malakmarwan/Space-Garden/docs/Space Garden Poster.png

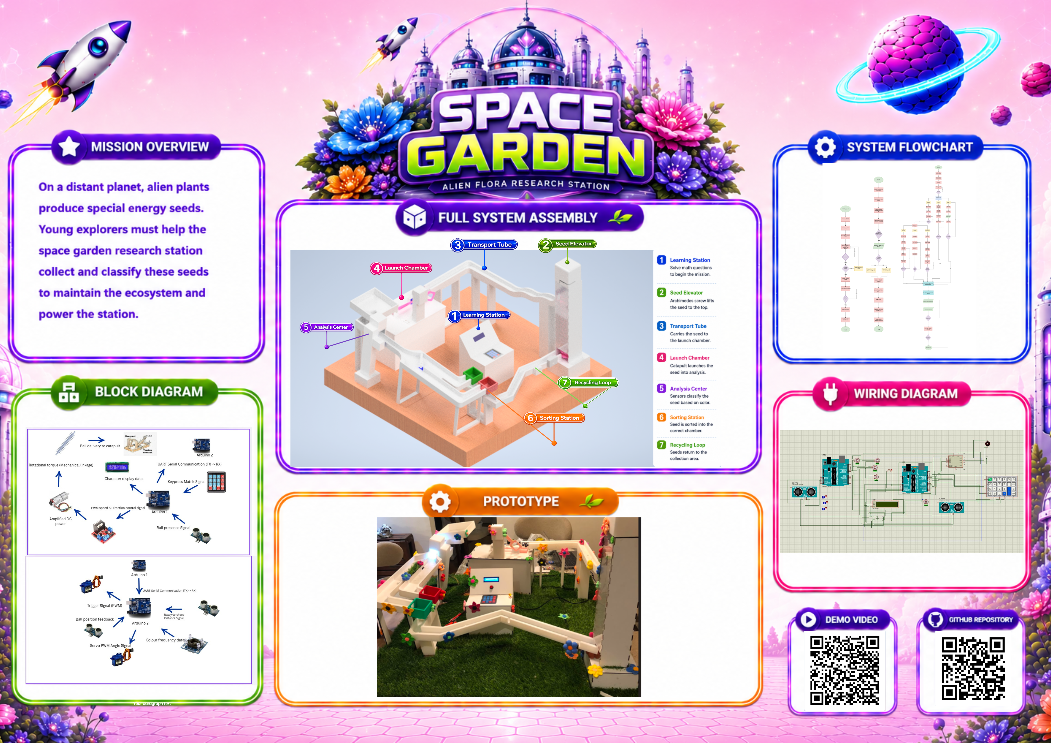
docs/Space Garden Poster.png
