malakmarwan/Space-Garden/Electrical/sorting mechanism wiring diagram.png

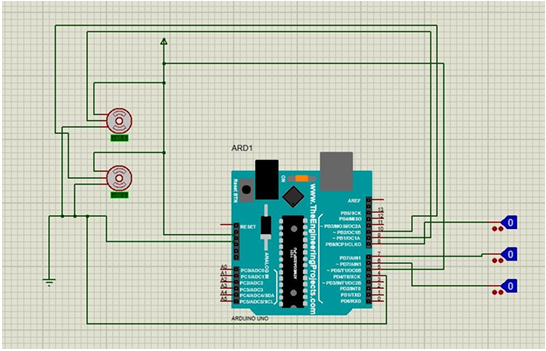
Electrical/sorting mechanism wiring diagram.png
