malakmarwan/Space-Garden/docs/Space Garden Report.pdf

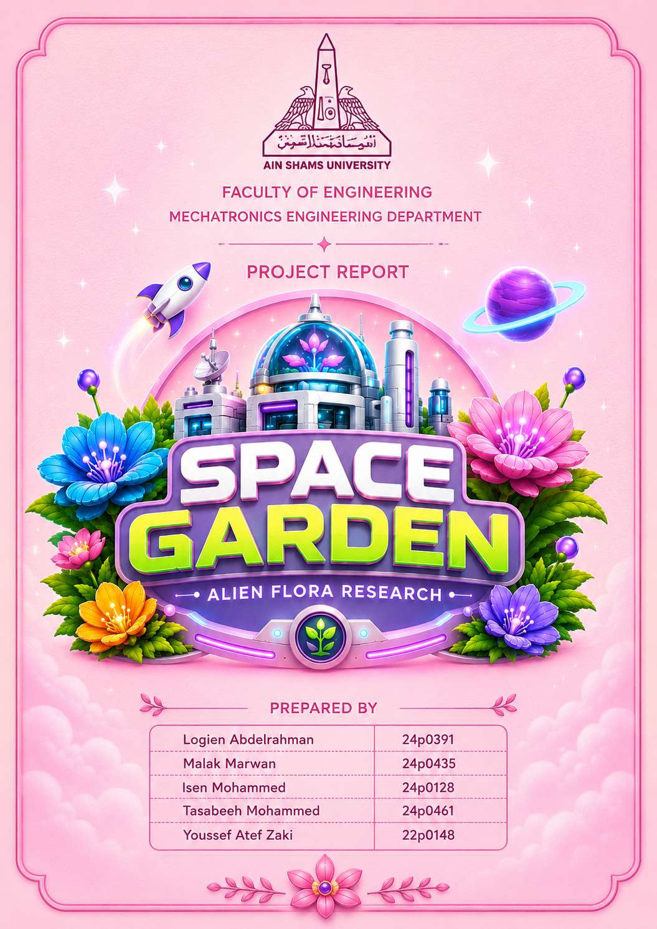
[picture p17: page 1]

This report details the design and implementation of an interactive educational mechatronics system developed. The project aims to bridge the gap between theoretical mathematical concepts and physical mechanical action through an automated sorting and delivery mechanism.

The core objective of this system is to create an engaging learning environment for children. The operational logic follows a feedback-controlled sequence:

1. User Interaction: A mathematical question is displayed on a digital interface.
2. Conditional Logic: If the child provides the correct answer, the system triggers the primary actuator to release a ball into the processing mechanisms.
- If the answer is incorrect, the system remains in a "hold" state, and the ball does not move, encouraging the user to try again.
3. Mechanical Execution: Once a correct answer is detected, the ball travels through a series of integrated subsystems, including vertical lifting, sorting mechanisms, and a final projectile shooting phase.

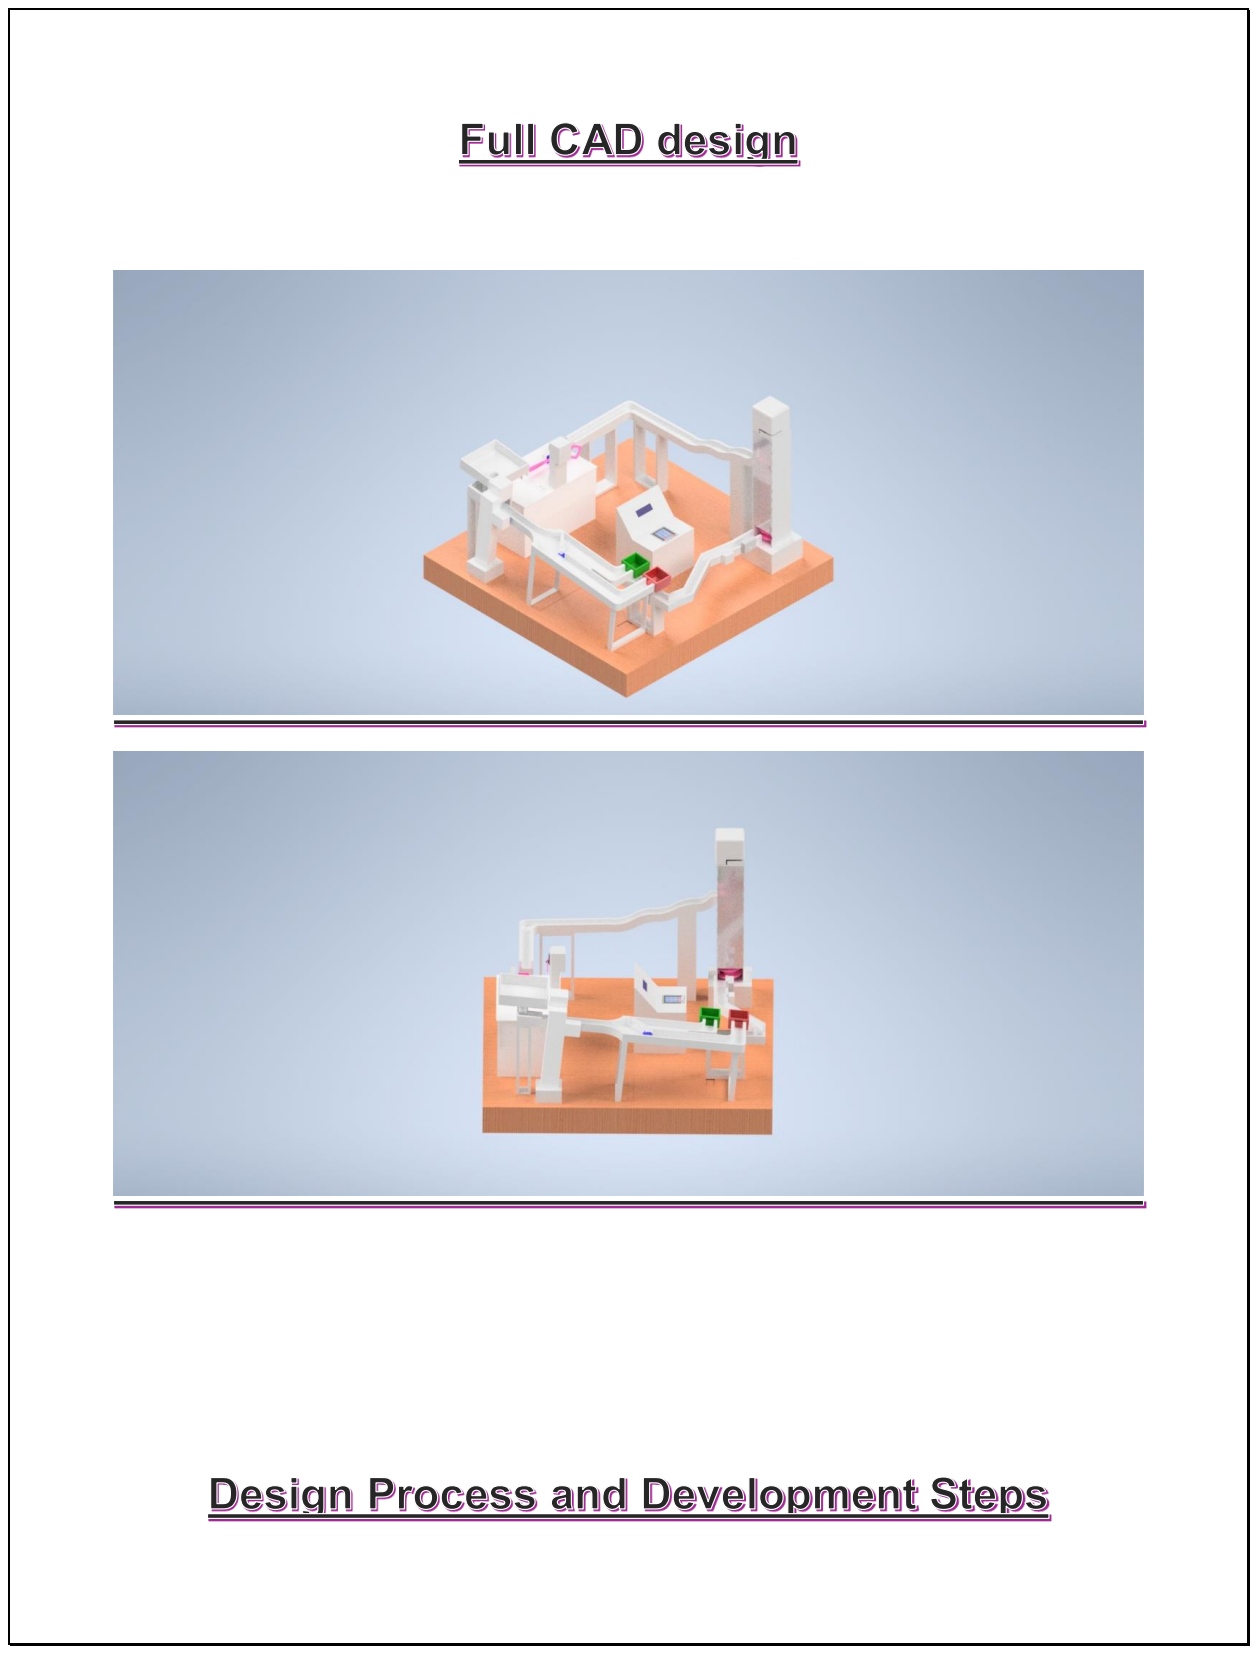
[picture p18: page 3]

### 1. Project Objective

The main objective of this project is to develop an automated ball sorting and handling system using Arduino-based control. The system combines color detection, object detection, user interaction, motor control, and servo mechanisms to create a complete automated process. The project was designed and simulated using Proteus before hardware implementation.

### 2. System Analysis

The required system functions were analyzed and divided into several stages:

1. User interaction and game control.
2. Ball detection.
3. Ball lifting mechanism.
4. Color recognition and sorting.
5. Ball shooting mechanism.
6. Communication between subsystems.

To simplify the design and reduce processing load, the system was divided into two Arduino controllers.

### 3. Hardware Selection

The following components were selected:

- Arduino Uno (2 units)
- LCD 16×2 I2C Display

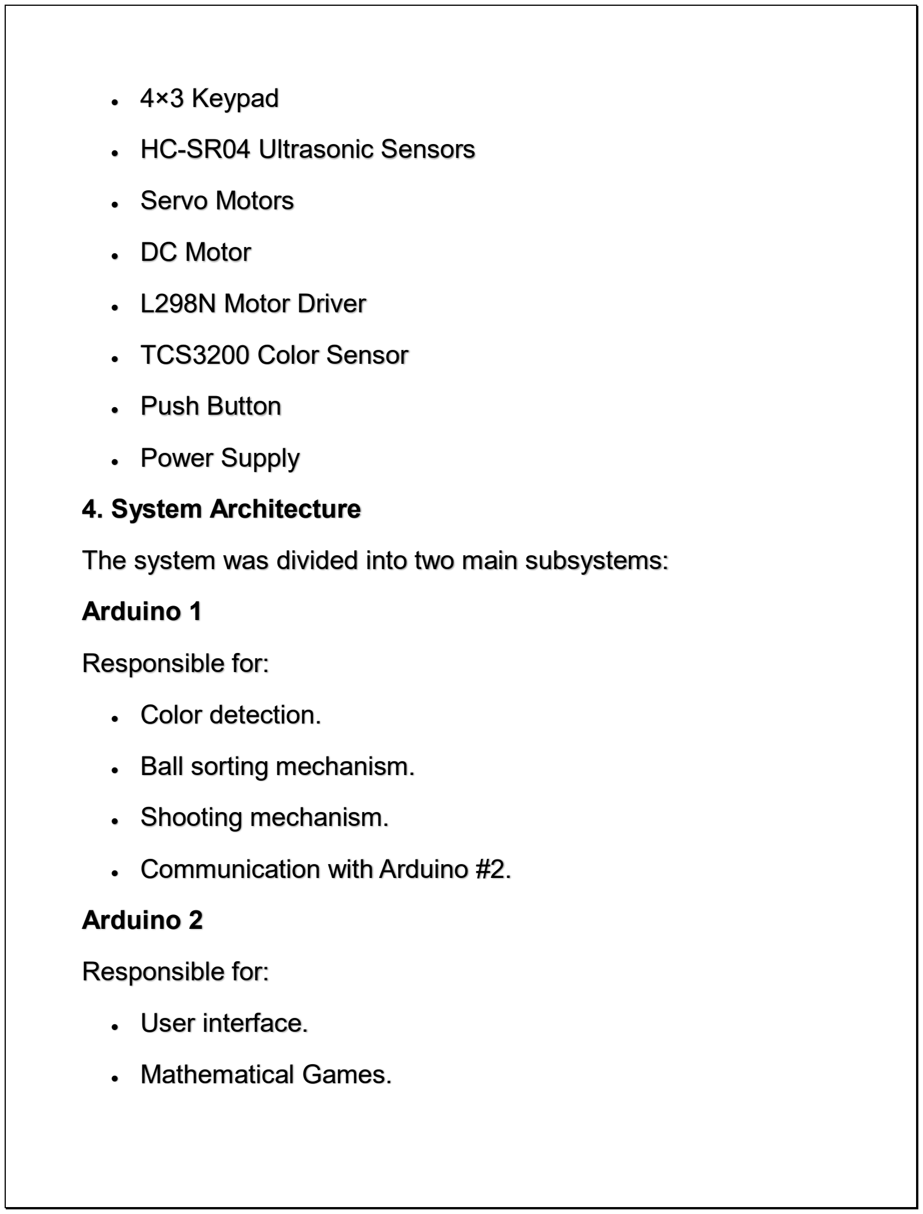
[picture p19: page 5]

- 4×3 Keypad
- HC-SR04 Ultrasonic Sensors
- Servo Motors
- DC Motor
- L298N Motor Driver
- TCS3200 Color Sensor
- Push Button
- Power Supply

### 4. System Architecture

The system was divided into two main subsystems:

Arduino 1

Responsible for:

- Color detection.
- Ball sorting mechanism.
- Shooting mechanism.
- Communication with Arduino #2.

Arduino 2

Responsible for:

- User interface.
- Mathematical Games.

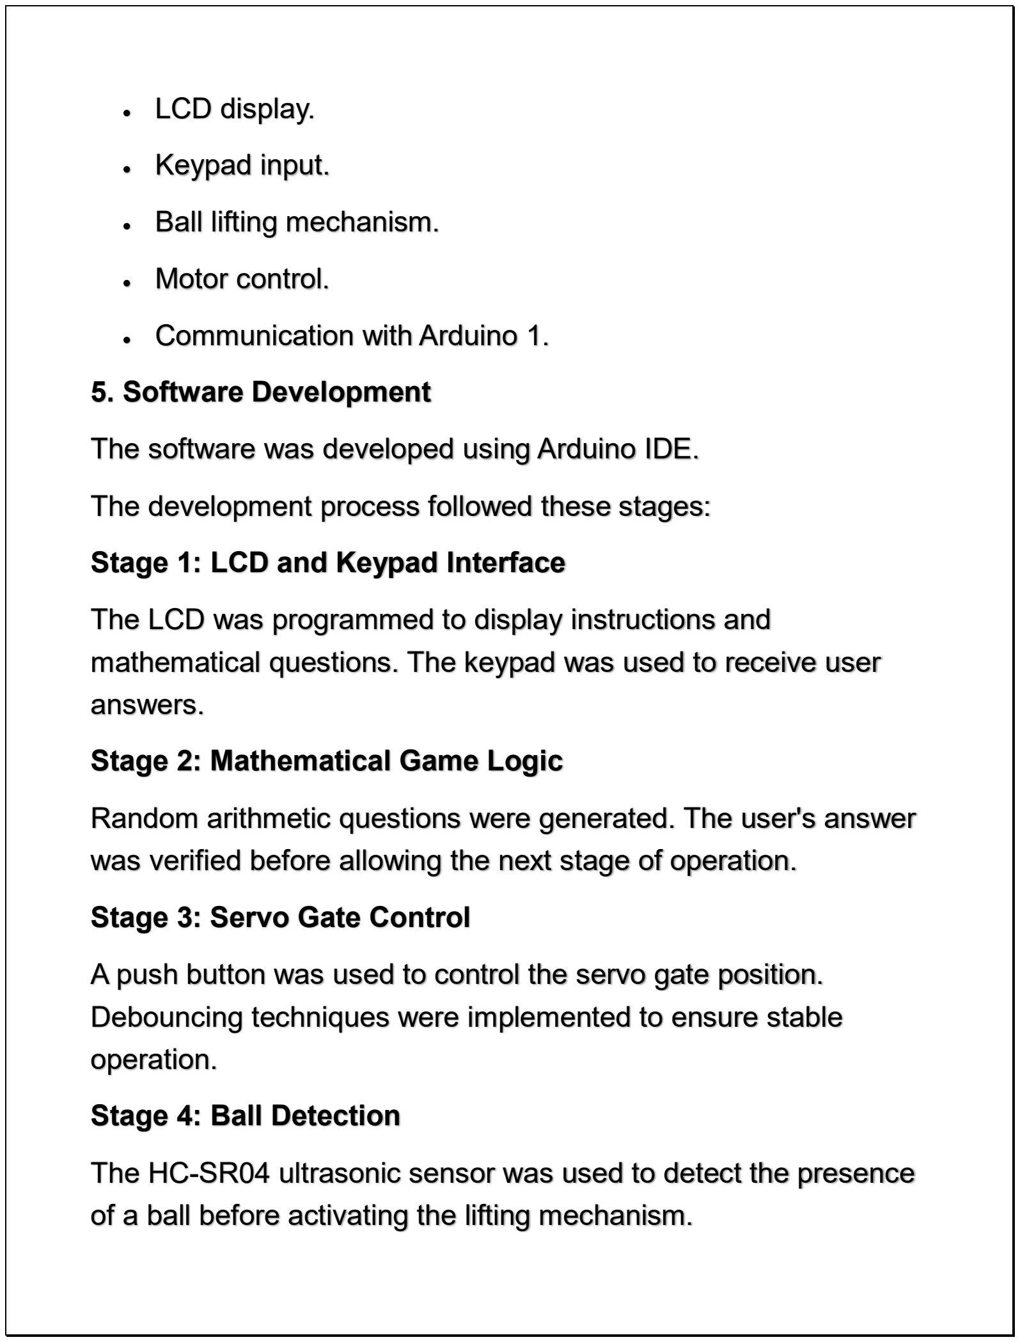
[picture p20: page 6]

- LCD display.
- Keypad input.
- Ball lifting mechanism.
- Motor control.
- Communication with Arduino 1.

### 5. Software Development

The software was developed using Arduino IDE.

The development process followed these stages:

Stage 1: LCD and Keypad Interface

The LCD was programmed to display instructions and mathematical questions. The keypad was used to receive user answers.

Stage 2: Mathematical Game Logic

Random arithmetic questions were generated. The user's answer was verified before allowing the next stage of operation.

Stage 3: Servo Gate Control

A push button was used to control the servo gate position. Debouncing techniques were implemented to ensure stable operation.

Stage 4: Ball Detection

The HC-SR04 ultrasonic sensor was used to detect the presence of a ball before activating the lifting mechanism.

Stage 5: Motor Control

The DC motor was controlled through an L298N motor driver. The motor operates for a predefined period to move the ball through the system.

Stage 6: Color Detection

The TCS3200 color sensor measures RGB values and compares them with calibrated reference values to identify ball color.

Stage 7: Sorting Mechanism

According to the detected color, servo motors move the sorting gate to direct the ball toward the appropriate path.

Stage 8: Shooting Mechanism

Additional servo motors perform the shooting sequence after successful sorting.

Stage 9: Arduino-to-Arduino Communication

Software Serial communication was implemented between the two Arduino boards to exchange system status messages such as:

- SHOOTING
- SORTING
- LIFTING

These messages are displayed on the LCD to provide user feedback.

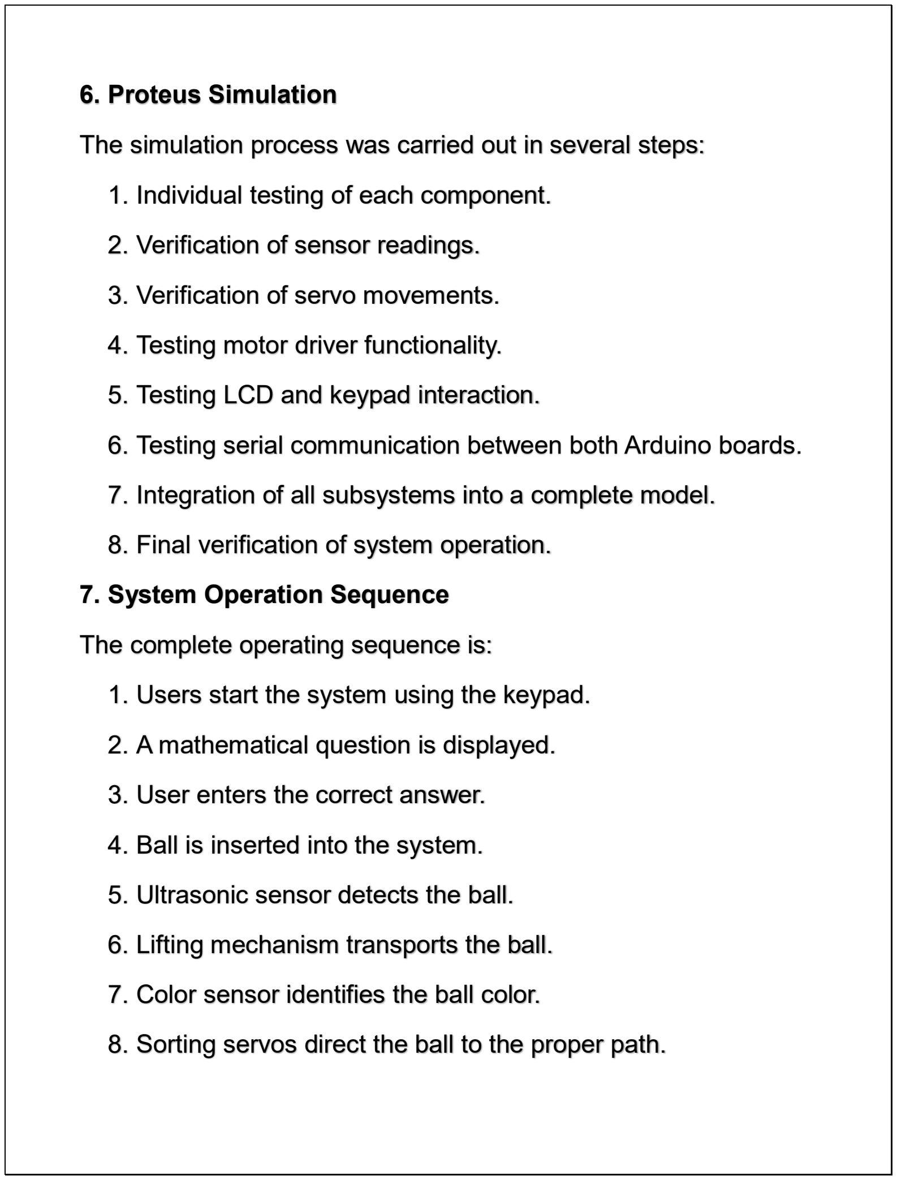
[picture p21: page 8]

### 6. Proteus Simulation

The simulation process was carried out in several steps:

1. Individual testing of each component.
2. Verification of sensor readings.
3. Verification of servo movements.
4. Testing motor driver functionality.
5. Testing LCD and keypad interaction.
6. Testing serial communication between both Arduino boards.
7. Integration of all subsystems into a complete model.
8. Final verification of system operation.

### 7. System Operation Sequence

The complete operating sequence is:

1. Users start the system using the keypad.
2. A mathematical question is displayed.
3. User enters the correct answer.
4. Ball is inserted into the system.
5. Ultrasonic sensor detects the ball.
6. Lifting mechanism transports the ball.
7. Color sensor identifies the ball color.
8. Sorting servos direct the ball to the proper path.

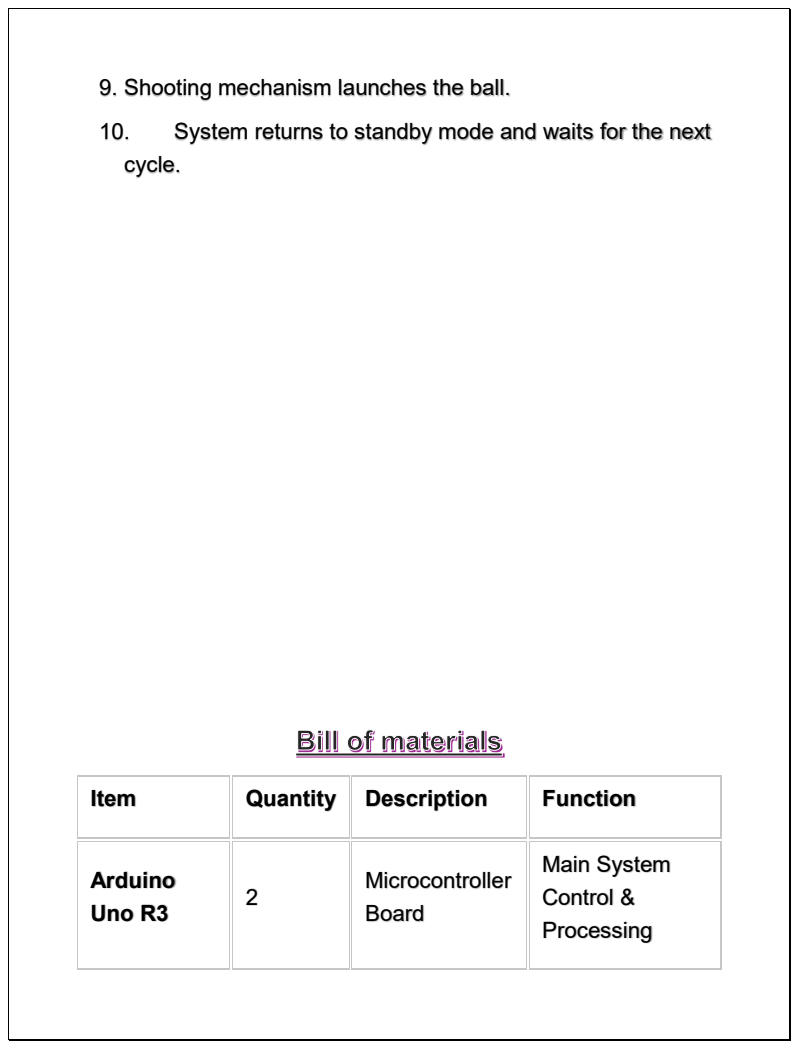
[picture p22: page 9]

9. Shooting mechanism launches the ball.

10. System returns to standby mode and waits for the next
cycle.

Item | Quantity | Description | Function

Arduino Uno R3 | 2 | Microcontroller Board | Main System Control & Processing

Item | Quantity | Description | Function

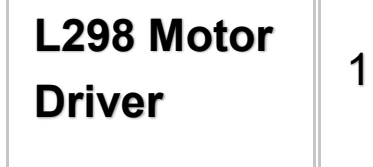
[picture p23: figure]

L298 Motor Driver | 1 | Dual H-Bridge Module | Motor Speed & Direction Control

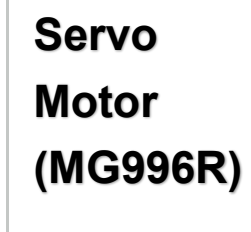
[picture p24: figure]
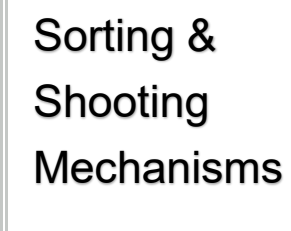
[picture p25: figure]

Servo Motor (MG996R) | 4 | High Torque Metal Gear | Sorting & Shooting Mechanisms

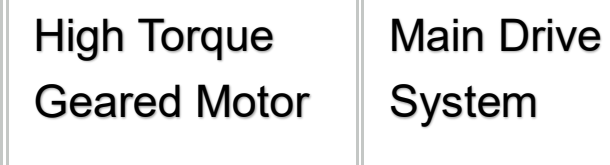
[picture p26: figure]

DC Motor (12V) | 1 | High Torque Geared Motor | Main Drive System

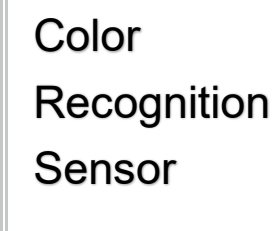
[picture p27: figure]

TCS3200 Sensor | 1 | Color Recognition Sensor | Ball Detection & Sorting

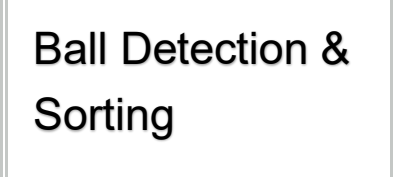
[picture p28: figure]
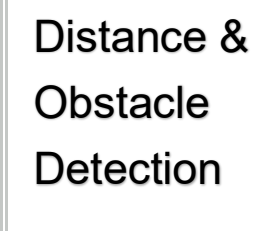
[picture p29: figure]

Ultrasonic Sensor | 2 | HC-SR04 | Distance & Obstacle Detection

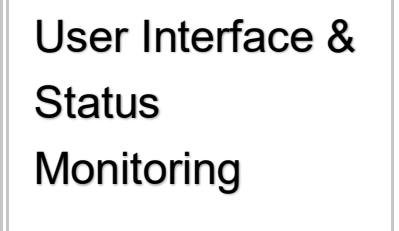
[picture p30: figure]

I2C LCD Display | 1 | 16x2 Character Display | User Interface & Status Monitoring
Keypad (4x4) | 1 | Membrane Keypad | User Input & Control

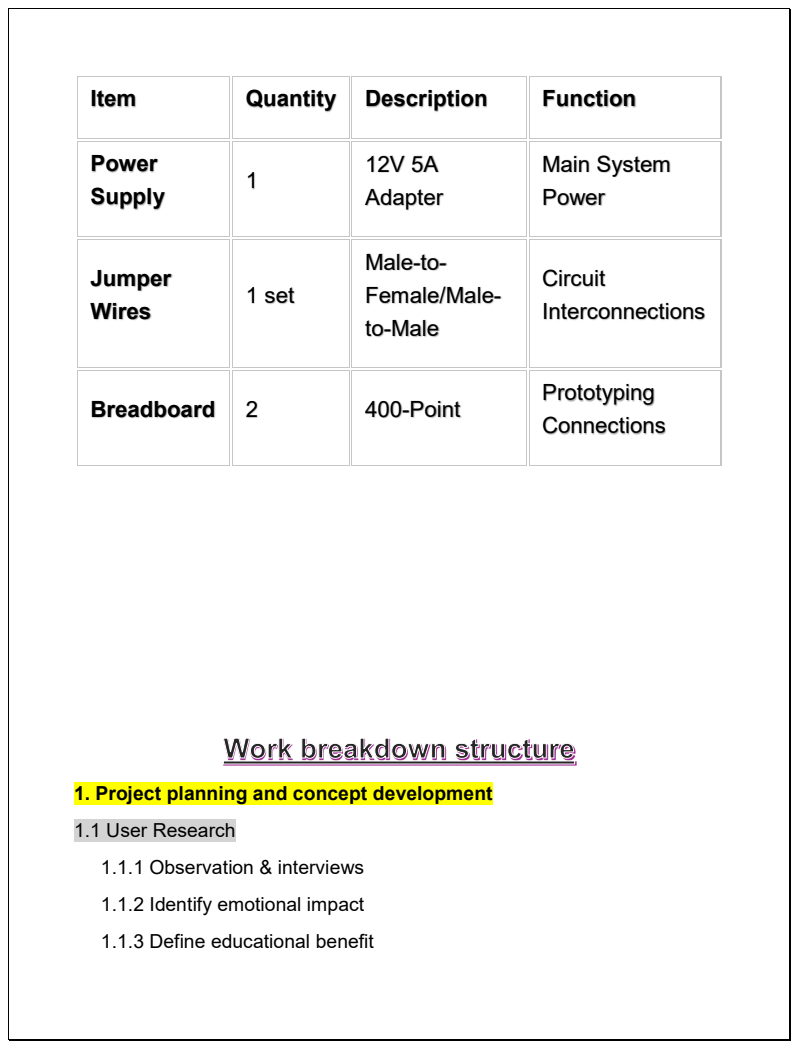
[picture p31: page 11]
1.1 User Research; 1.1.1 Observation & interviews

Item | Quantity | Description | Function

Power Supply | 1 | 12V 5A Adapter | Main System Power

Jumper Wires | 1 set | Male-to-Female/Male-to-Male | Circuit Interconnections

Breadboard | 2 | 400-Point | Prototyping Connections

1. Project planning and concept development

1.1.2 Identify emotional impact

1.1.3 Define educational benefit

1.2 Problem Definition

1.2.1 Requirement Analysis (sorting, shooting, lifting)

1.2.2 Define educational objectives

1.2.3 Define constraints (size, cost, safety)

1.3 Ideation

1.3.1Mind maps

1.3.2 Mood boards

1.3.3 Sketches

1.3.4 Concept selection

1.4 Product Design Specifications

### 2. Mechanical Subsystems

2.1 Vertical Lifting Mechanism

2.1.1 Mechanism selection

2.1.2 Torque calculation

2.1.3 Motor sizing

2.1.4 CAD modeling

2.1.5 Mechanical testing

2.2 Sorting Mechanism

2.2.1 Sorting principle (Color)

2.2.2 Sensor selection

2.2.3 Mechanical gate design (inventor)

2.2.4 Sorting validation testing

2.3 Projectile Shooting Mechanism

2.3.1 Concept selection (catapult)

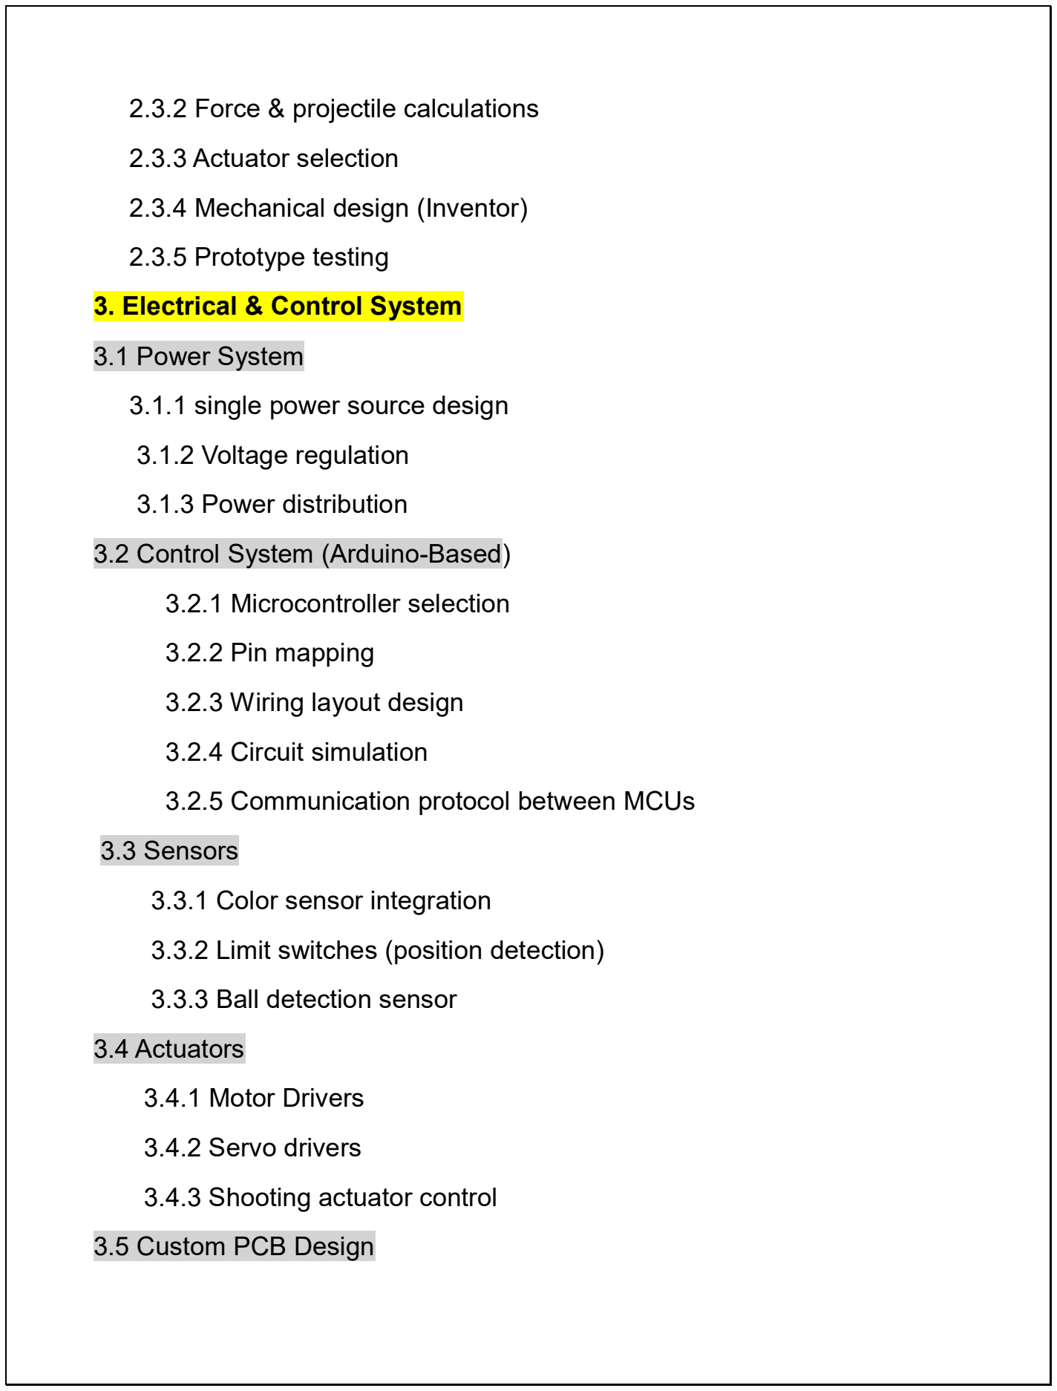
[picture p32: figure]
2.3.2 Force & projectile calculations; 2.3.3 Actuator selection; 2.3.4 Mechanical design (Inventor); 2.3.5 Prototype testing; 3. Electrical & Control System; 3.1 Power System; 3.1.1 single power source design; 3.1.2 Voltage regulation; 3.1.3 Power distribution; 3.2 Control System (Arduino-Based); 3.2.1 Microcontroller selection; 3.2.2 Pin mapping; 3.2.3 Wiring layout design; 3.2.4 Circuit simulation; 3.3 Sensors; 3.3.1 Color sensor integration; 3.3.3 Ball detection sensor; 3.4 Actuators; 3.4.1 Motor Drivers; 3.4.2 Servo drivers; 3.4.3 Shooting actuator control; 3.5 Custom PCB Design

3.2.5 Communication protocol between MCUs

3.3.2 Limit switches (position detection)

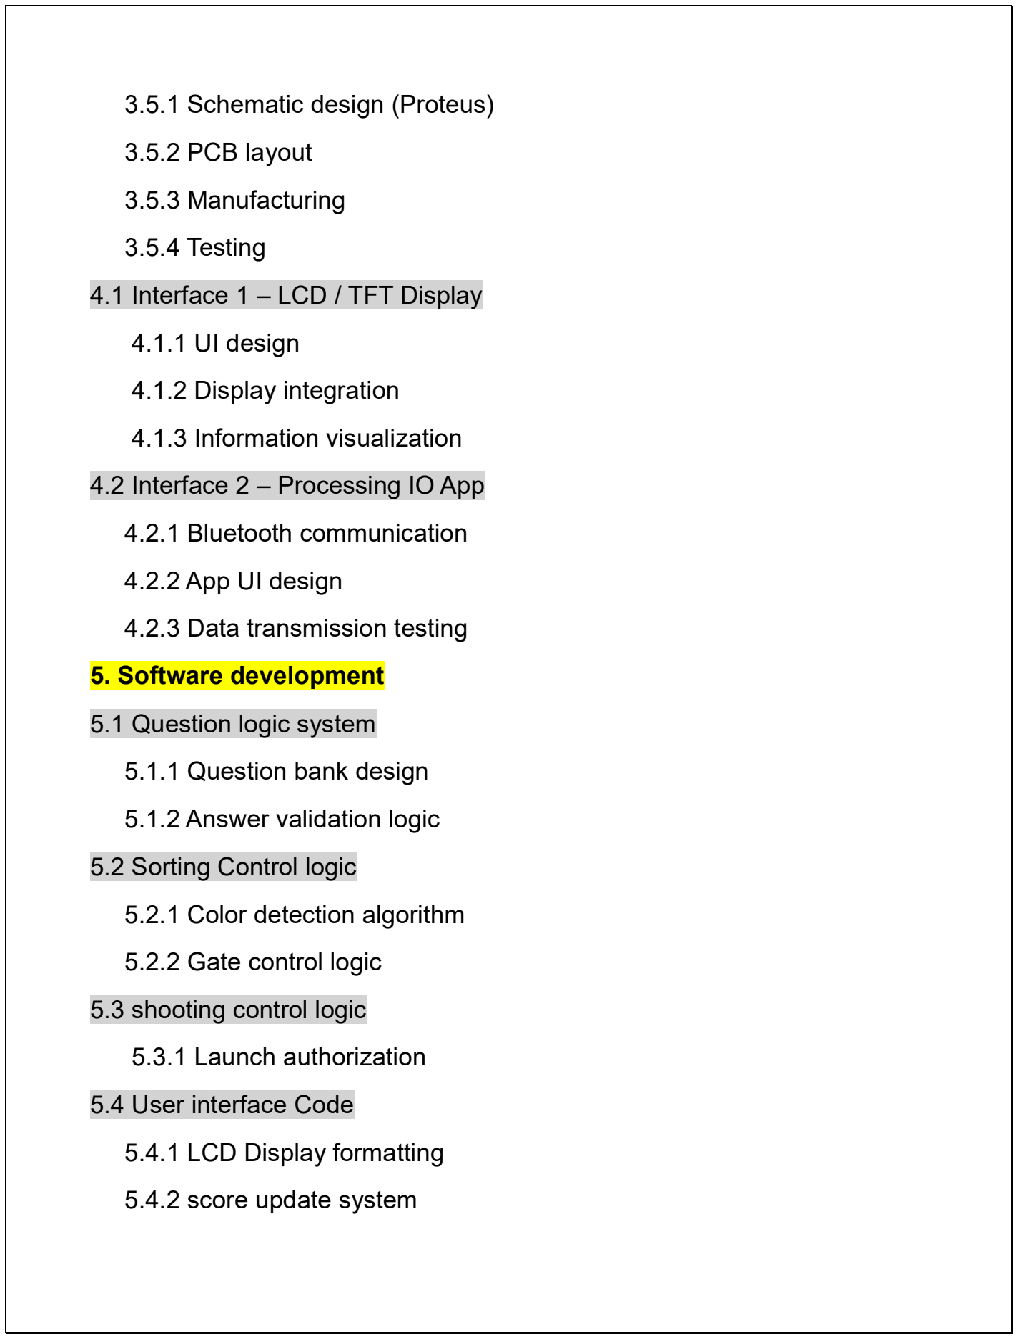
[picture p33: figure]
3.5.1 Schematic design (Proteus); 3.5.2 PCB layout; 3.5.3 Manufacturing; 3.5.4 Testing; 4.1 Interface 1 – LCD / TFT Display; 4.1.1 UI design; 4.1.2 Display integration; 4.1.3 Information visualization; 4.2 Interface 2 – Processing IO App; 4.2.1 Bluetooth communication; 4.2.2 App UI design; 4.2.3 Data transmission testing; 5. Software development; 5.1 Question logic system; 5.1.1 Question bank design; 5.1.2 Answer validation logic; 5.2 Sorting Control logic; 5.2.1 Color detection algorithm; 5.2.2 Gate control logic; 5.3 shooting control logic; 5.3.1 Launch authorization; 5.4 User interface Code; 5.4.1 LCD Display formatting; 5.4.2 score update system

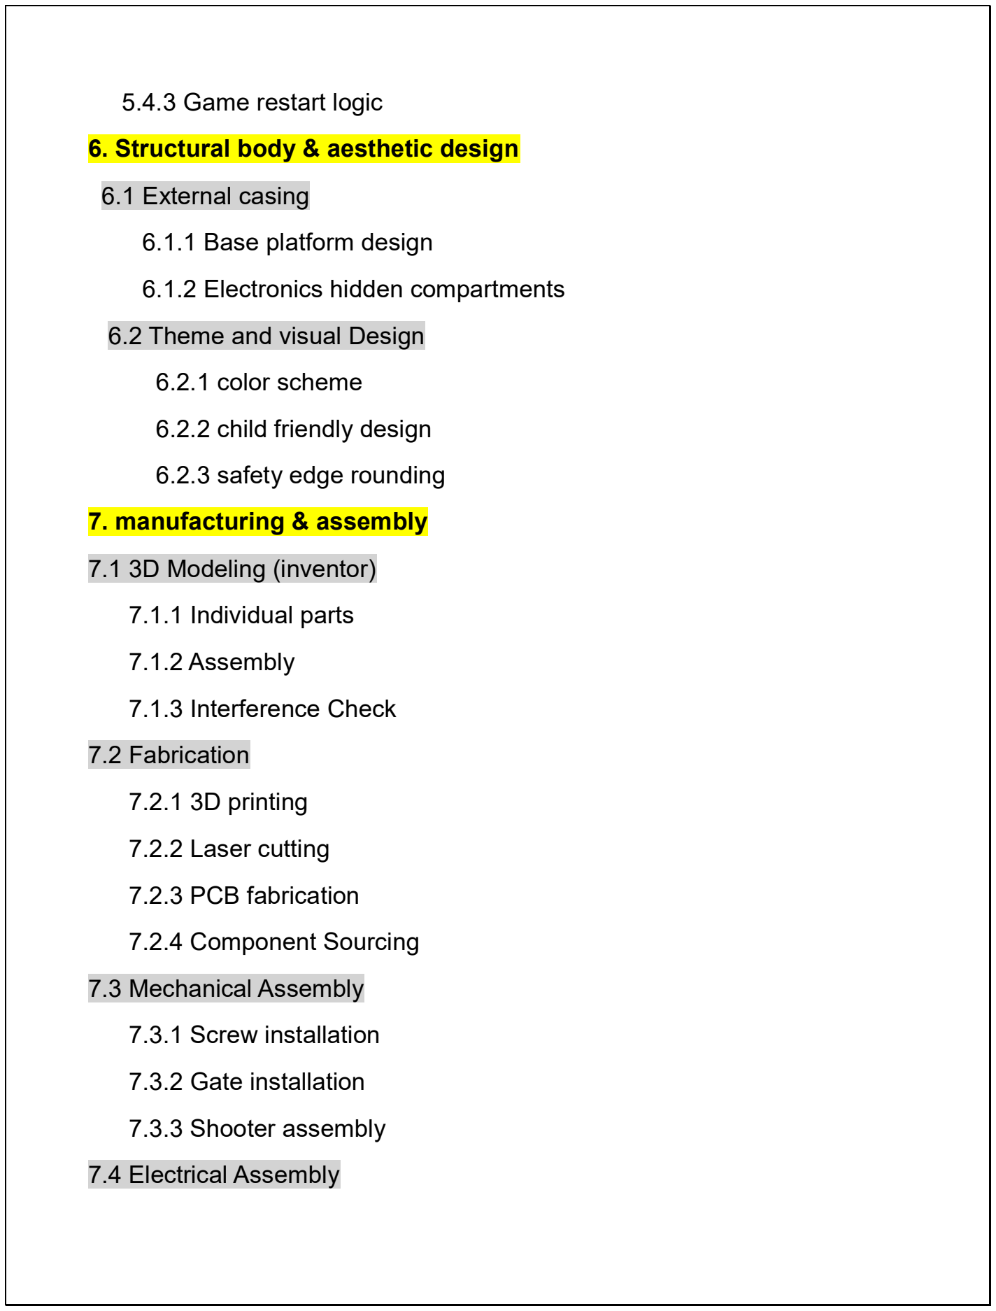
[picture p34: figure]
5.4.3 Game restart logic; 6. Structural body & aesthetic design; 6.1 External casing; 6.1.1 Base platform design; 6.1.2 Electronics hidden compartments; 6.2 Theme and visual Design; 6.2.1 color scheme; 6.2.2 child friendly design; 6.2.3 safety edge rounding; 7. manufacturing & assembly; 7.1 3D Modeling (inventor); 7.1.1 Individual parts; 7.1.2 Assembly; 7.1.3 Interference Check; 7.2 Fabrication; 7.2.1 3D printing; 7.2.2 Laser cutting; 7.2.3 PCB fabrication; 7.2.4 Component Sourcing; 7.3 Mechanical Assembly; 7.3.1 Screw installation; 7.3.2 Gate installation; 7.3.3 Shooter assembly; 7.4 Electrical Assembly

7.4.1 Wiring per Module

7.4.2 Cable management

7.5 System Integration

7.5.1 Mechanical–Electrical Integration

7.5.1.1 1Install motors into mechanical structure

7.5.1.2 Mount sensors in final positions

7.5.1.3 Connect actuators to control system

7.5.2 Electrical–Control Integration

7.5.2.1 Connect drivers to microcontrollers

7.5.2.2 Upload Code to MCU1

7.5.2.3 Upload code to MCU2

7.5.2.4 Establish communication protocol between MCUs

7.5.3 User Interface Integration

7.5.3.1Connect LCD to main controller

7.5.3.2 Implement UI logic

7.5.3.3 Integrate Bluetooth module

7.5.3.4 Connect Processing app to MCU

7.5.4 Power System Integration

7.5.4.1 Connect single power source

7.5.5 Module Interconnection

7.5.5.1 Connect modular wiring plugs

7.5.5.2 Final assembly to main board

### 8. Testing and Validation

8.1 Mechanical testing

8.1.1 Screw efficiency test

8.1.2 Sorting accuracy test

8.1.3 Launch consistency test

8.2 Electrical Testing

8.2.1 power stability

8.2.2 sensor accuracy

8.2.3 motor control

8.3 system integration testing

8.3.1 Mechanical–Electrical Integration

8.3.1.1 Verify motors respond to control signals

8.3.1.2 Verify sensors trigger mechanical actions

8.3.2 MCU Communication Verification

8.3.2.1Test MCU1 ↔ MCU2 communication

8.3.2.2 Validate data transmission

8.3.3 Closed-Loop Operation Test

8.3.3.1 Marble insertion test

8.3.3.2Full internal cycle validation

8.3.3.3 Marble retention check (no escape from system)

8.3.4 User Interface Integration

8.3.4.1 LCD displays correct real-time data

8.3.4.2 App updates correctly

8.3.4.3 Button inputs trigger correct actions

### 9. documentation and deliverables

9.1 Technical Report

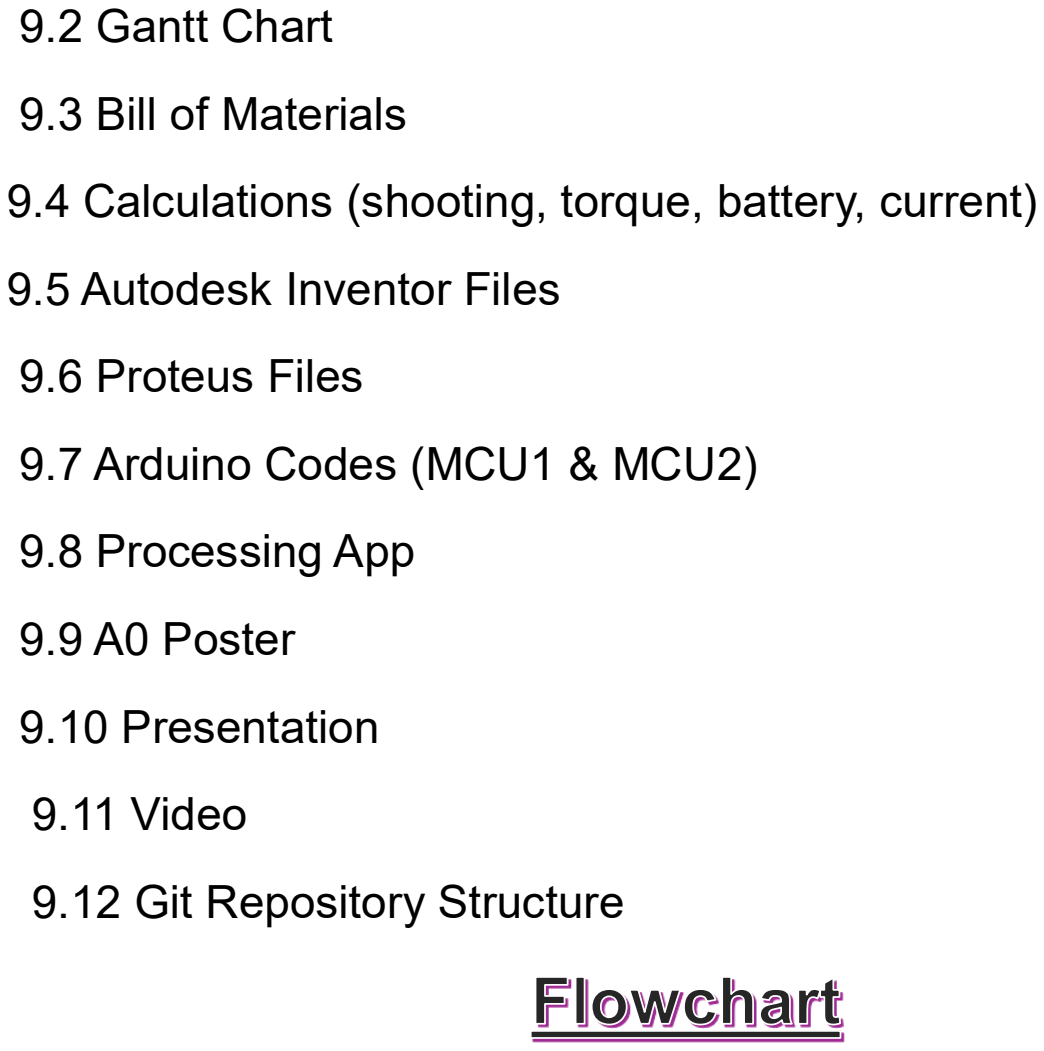
[picture p35: page 18]
9.2 Gantt Chart; 9.6 Proteus Files; 9.7 Arduino Codes (MCU1 & MCU2); 9.8 Processing App; 9.9 A0 Poster; 9.10 Presentation; 9.11 Video

9.3 Bill of Materials

9.4 Calculations (shooting, torque, battery, current)

9.5 Autodesk Inventor Files

9.12 Git Repository Structure

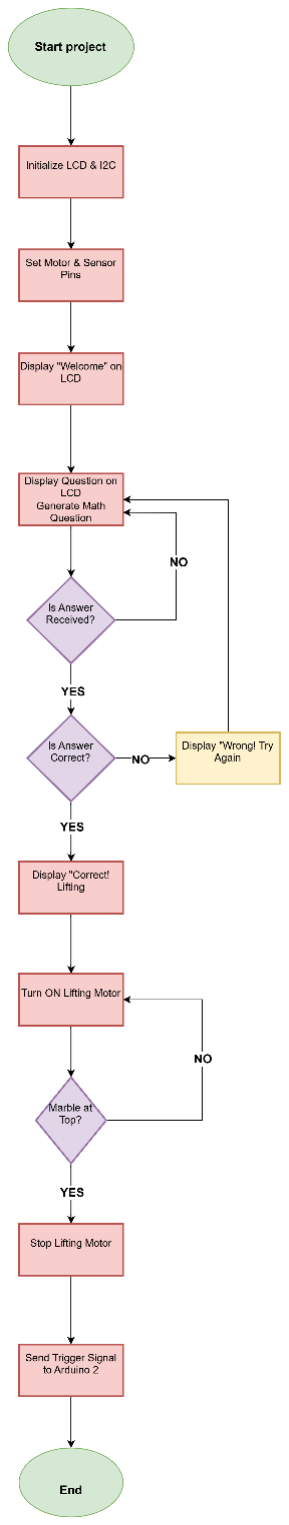
[picture p36: figure]

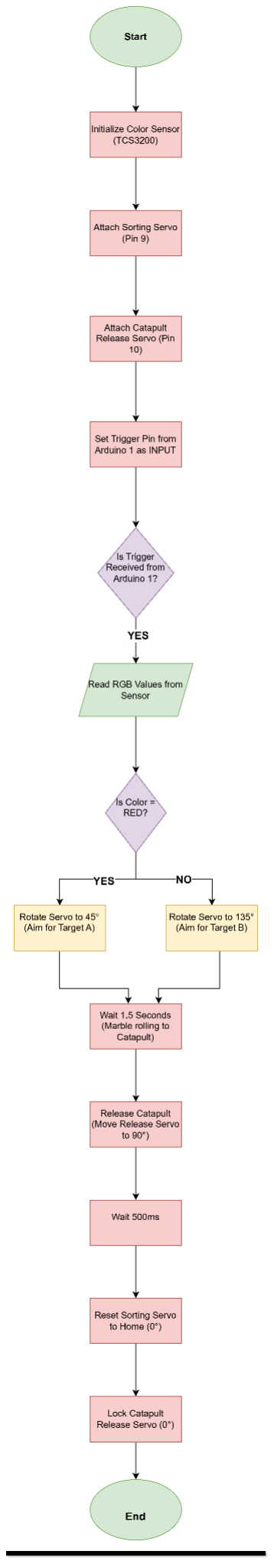
[picture p37: figure]

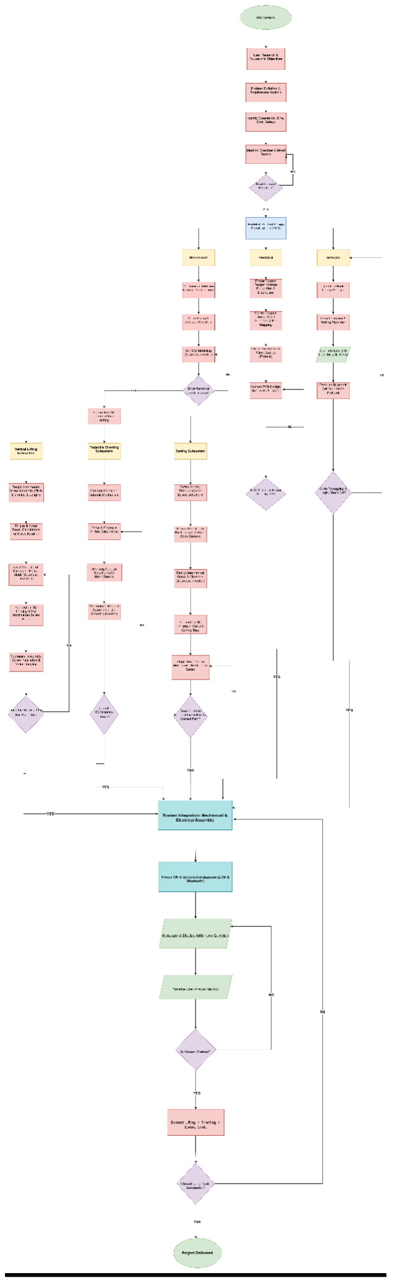
[picture p38: figure]
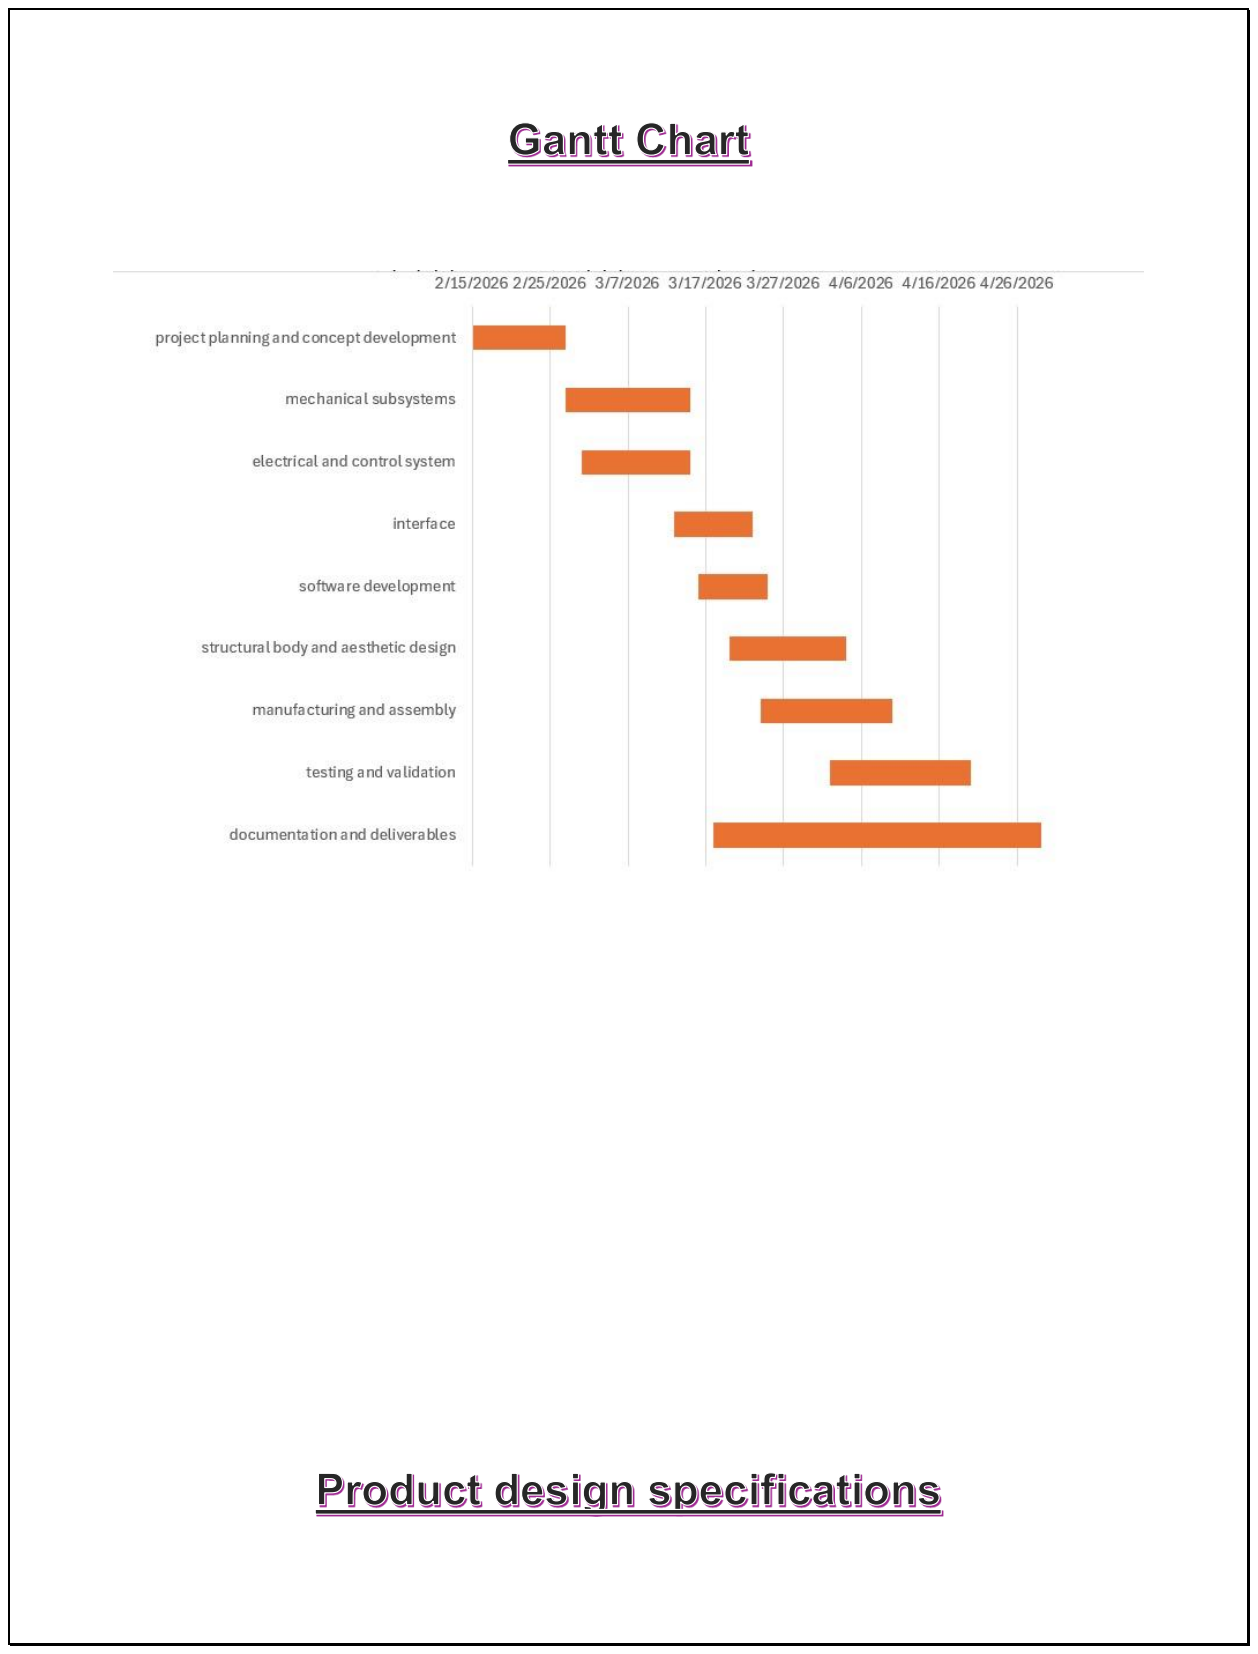
[picture p39: page 22]

Product overview:

The product shall be an interactive educational toy designed to support children with dyslexia through structured multisensory learning. The system integrates mechanical subsystems (lifting, sorting and shooting) with electronic feedback to create an engaging cause -and-effect learning environment.

Requirement category | Specifications
Target audience | • Children aged 6-10 years • Diagnosed or showing symptoms of dyslexia • Usable in homes, therapy centers, and schools • Parents struggling with their dyslexic children
User requirements & Research | • User Needs: Specific needs identified through user research. • Emotional Impact: The intended emotional response or engagement for the child. • Educational Impact: Description of how the toy aids in learning or skill development.
Mechanical requirements | • Vertical Lifting Mechanism: This system is responsible for moving the marbles from a lower reservoir or entry point to a higher elevation to gain potential energy. • Sorting Mechanism: The toy must be able to automatically categorize marbles based on physical property (color). • Projectile-Based Shooting Mechanism: After the lifting and sorting phases, the toy must launch the marbles toward a target using a mechanism like a catapult or a spring-loaded launcher.
System flow (closed-loop operation) | The toy is required to operate as a self-contained environment: • Single Entry Point: Users should insert marbles through one designated inlet.

- Internal Pathway: Once inserted, the marble must stay within the toy’s internal tracks or mechanisms throughout the entire operation cycle.
- Continuous Loop: The flow should ideally transition from entry to lifting, then sorting, and finally shooting, potentially returning the marble to the start or a collection bin within the 100 cm X 100 cm footprint.
Control electronics | This section details the "brain" and power architecture of your mechatronic system:
| • Dual Microcontroller Setup: At least two microcontrollers (such as the Arduino Uno) that communicate with each other. • Custom PCB Requirements: At least one part of the circuit must be built on a custom- manufactured PCB rather than just a breadboard or protoboard. • Single power source: The entire system including all motors, sensors, and screens must be powered by a single unified power supply. • Dual User Interfaces:
1. Interface 1: An LCD connected directly
| to the Arduino to show real-time data.
2. Interface 2: A mobile or PC application
| created with Processing.io that communicates with the toy via Bluetooth.

Manufacturing &
Maintenance
- Modularity: Requirements for individual wiring plugs and assembly connections for easy disassembly.
- Materials: List of prototyping tools and materials suitable for a child's toy.

| • Technical Documentation: Requirements for Autodesk Inventor (mechanical) and Proteus (electrical) files.
Modularity and Safety | • Modular Assembly: The project must be divided into modules, each with its own wiring and connection plugs, to allow for easy assembly and disassembly. • Hidden Wiring: To ensure safety for the 2–10 age group, all wires and electrical components must be hidden from view.
Power consumption | • This section details the power architecture of the mechatronic system, ensuring compliance with the "Single power source" requirement and the safety standards for the target audience (children aged 6-10).

For lifting mechanism:

Component | Voltage | Current | Power

Dc motor | 12 V | 0.6 A | 7.2 W
2 IR sensors | 5 V | 0.04 A | 0.2 W
Total | 12 V | 0.64 A | 7.68 W

Total time = 7.5 sec

For sorting mechanism:

Component | Voltage | Current | Power
Color sensor (TCS3200) | 5 V | 0.02 A | 0.1 W
Sorting servo motor | 5 V | 0.5 A | 2.5 W
Total | 5 V | 0.52 A | 2.6 W

Total time = 0.9 sec

For shooting mechanism:

Component | Voltage | Current | Power
High torque servo (catapult) | 5 V | 1 A | 5 W
Total | 5 V | 1 A | 5 W

Total time: 0.5 sec

Sure. You can copy the following section directly into your report:

Subsystem Current Consumption

Component | Quantity Current per Unit
(mA)

Total Current
(mA)
Arduino Uno | 2 | 50 | 100
LCD 16×2 I2C | 1 | 30 | 30
Keypad 4×3 | 1 | 1 | 1

HC-SR04 Ultrasonic
Sensor | 2 | 15 | 30
TCS3200 Color Sensor | 1 | 20 | 20
Servo Motors | 4 | 500 | 2000
DC Motor | 1 | 800 | 800
L298N Motor Driver | 1 | 20 | 20

Total Current Consumption

The total current consumption of the system is calculated as follows:

I total = 100 + 30 + 1 + 30 + 20 + 2000 + 800 + 20

I total = 3001 mA

I total ≈ 3.0 A

Safety Factor

To account for startup currents, load variations, and future expansion, a safety factor of 25% is added:

I required = 1.25 × 3.0

I required = 3.75 A

Power Supply Selection

Based on the calculated current requirements, a power supply capable of delivering at least 4 A is recommended to ensure stable and reliable operation of the complete mechatronic system.

Therefore, the recommended power supply specifications are:

- Control Voltage: 5 V DC
- Minimum Current Rating: 4 A
- Motor Supply Voltage: According to the DC motor specifications

This power supply provides sufficient current for all sensors, actuators, controllers, and communication modules while maintaining safe operating conditions.

Battery Sizing

The battery capacity must be sufficient to supply the required current for the desired operating time of the mechatronic system.

Total Current Requirement

From the current consumption analysis, the total system current is approximately:

I total = 3 A

Including a safety margin of 25%:

I required = 3.75 A

Battery Capacity Calculation

Battery capacity is calculated using:

Capacity (Ah) = Current (A) × Operating Time (h)

Assuming the system is required to operate continuously for 2 hours:

Capacity = 3.75 × 2

Capacity = 7.5 Ah

Battery Selection

The battery is selected with a capacity greater than the calculated value to compensate for efficiency losses and battery aging.

Recommended battery specifications:

- Battery Voltage: 12 V DC
- Battery Capacity: 8 Ah minimum
- Recommended Capacity: 10 Ah

Energy Calculation

The required battery energy can be estimated as:

Energy (Wh) = Voltage (V) × Capacity (Ah)

For a 12 V, 10 Ah battery:

Energy = 12 × 10

Energy = 120 Wh

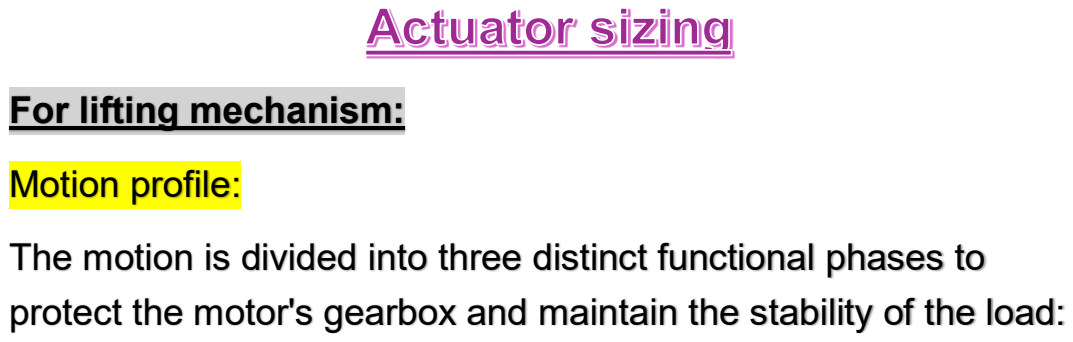
[picture p40: page 30]
Motion profile:

For lifting mechanism:

The motion is divided into three distinct functional phases to
protect the motor's gearbox and maintain the stability of the load:

Acceleration Phase (t acceleration): The actuator ramps from rest to the maximum operational angular velocity (omega_{max}). This prevents sudden torque spikes and motor stalling.

- Duration: 0.5 s.

Constant Velocity Phase (t constant): The screw rotates at a steady state, providing a stable window for the color and proximity sensors to sample data.

- Calculation: t constant = T total - (t acceleration + t deceleration)

T constant = 7.5 – (0.5 + 0.5) = 6.5 s

- Duration: 6.5 s

Deceleration Phase (t deceleration): The velocity is decreased linearly to zero. This ensures the ball is positioned accurately for the projectile mechanism without overshooting due to inertia.

- Duration: 0.5s

System Synchronization and Dwell Time: The Dwell Time is defined as the stationary period between two consecutive lifting cycles. In this specific mechanism, it serves as a synchronization buffer to ensure:

- Inter-mechanism Handover: The ball is successfully transferred from the Archimedes screw to the sorting/projectile assembly.
- Actuator Reset: Providing sufficient time for the projectile servos or solenoids to return to their "home" position.

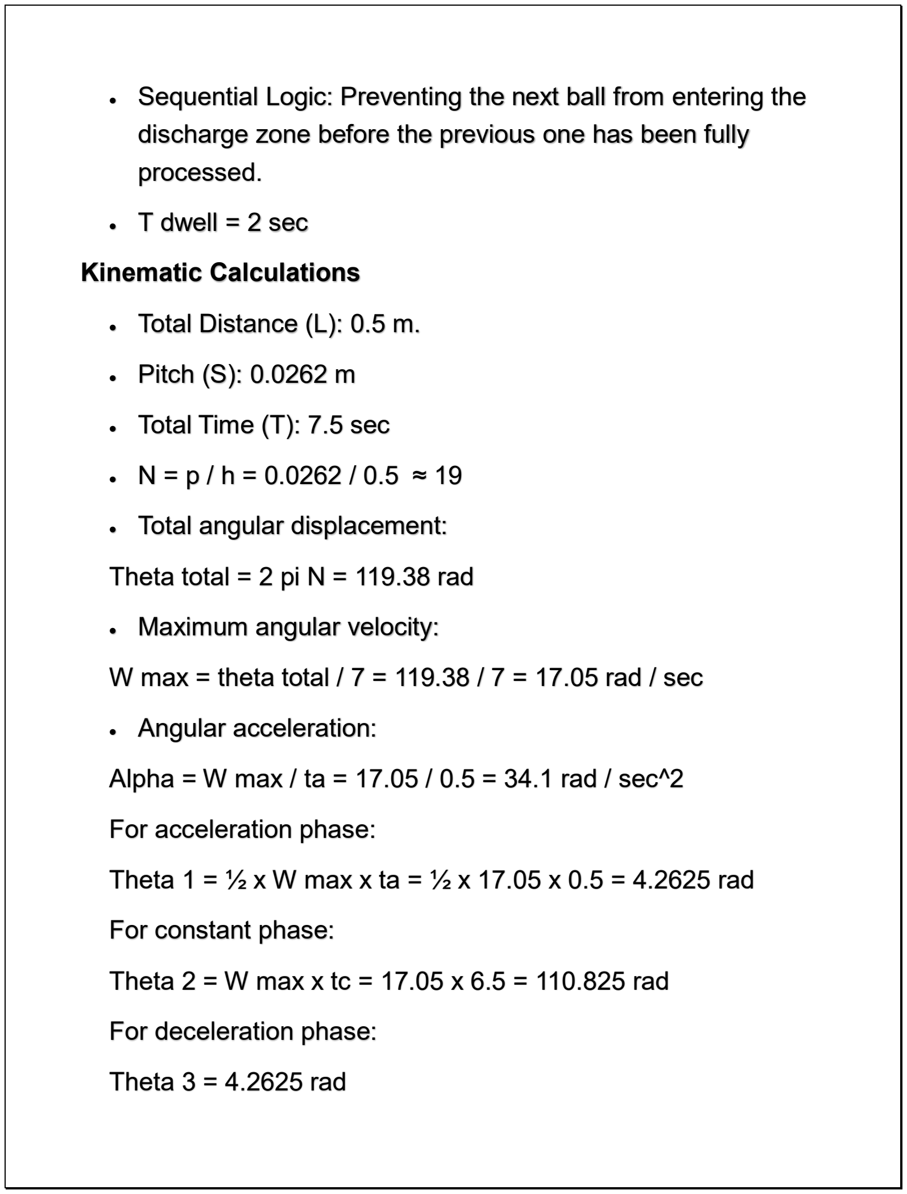
[picture p41: page 32]

- Sequential Logic: Preventing the next ball from entering the discharge zone before the previous one has been fully processed.
- T dwell = 2 sec

Kinematic Calculations

- Total Distance (L): 0.5 m.
- Pitch (S): 0.0262 m
- Total Time (T): 7.5 sec
- N = p / h = 0.0262 / 0.5 ≈ 19
- Total angular displacement:

Theta total = 2 pi N = 119.38 rad

- Maximum angular velocity:

W max = theta total / 7 = 119.38 / 7 = 17.05 rad / sec

- Angular acceleration:

Alpha = W max / ta = 17.05 / 0.5 = 34.1 rad / sec^2

For acceleration phase:

Theta 1 = ½ x W max x ta = ½ x 17.05 x 0.5 = 4.2625 rad

For constant phase:

Theta 2 = W max x tc = 17.05 x 6.5 = 110.825 rad

For deceleration phase:

Theta 3 = 4.2625 rad

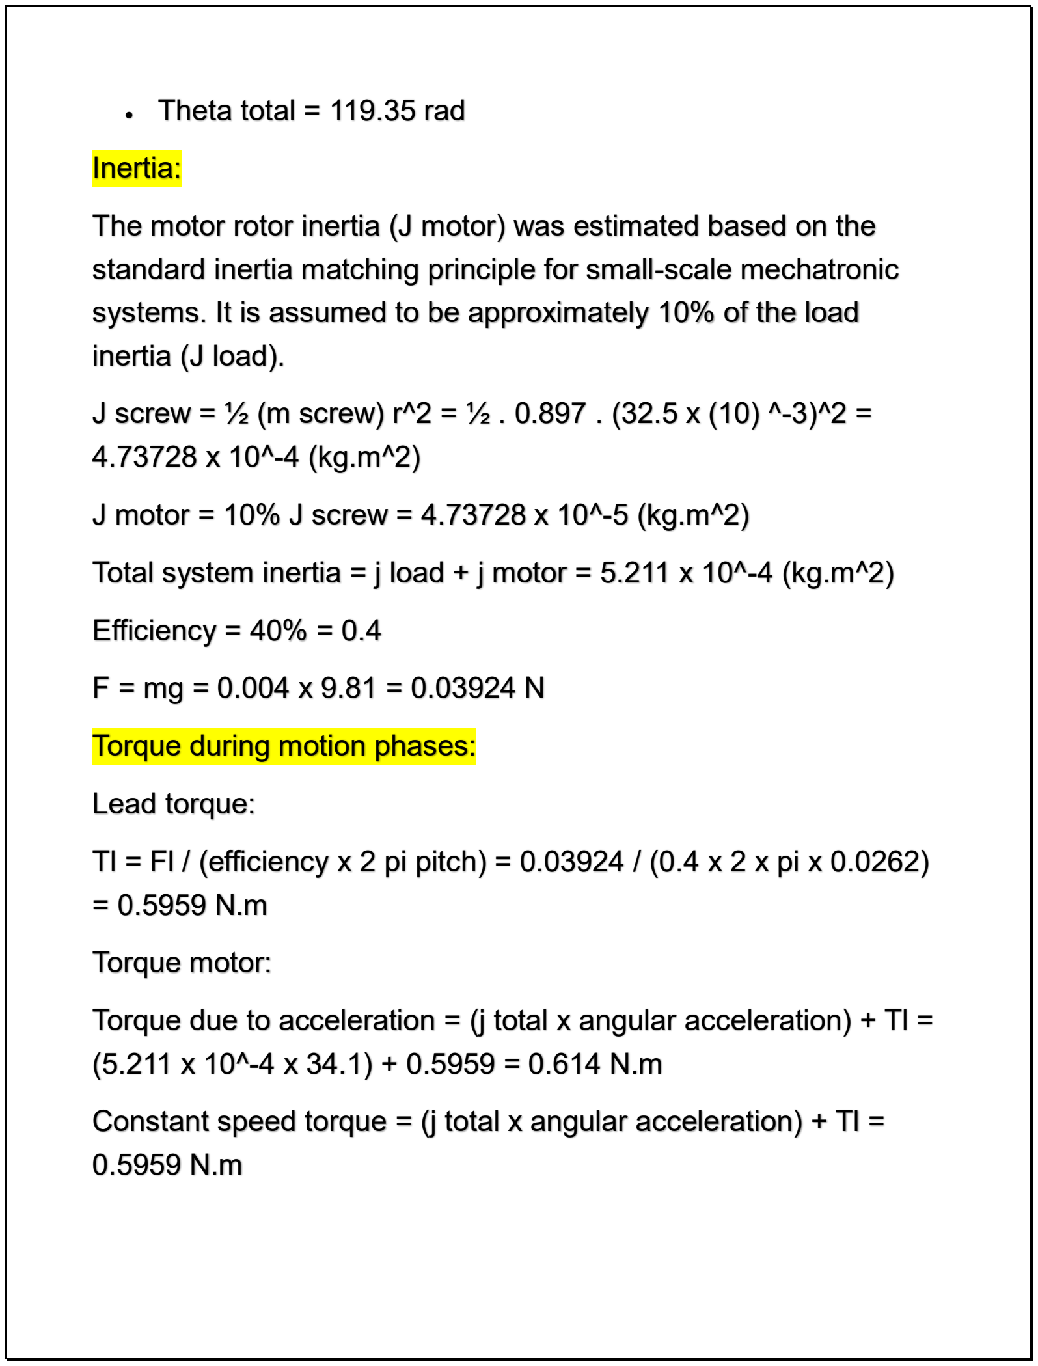
[picture p42: page 33]

- Theta total = 119.35 rad

Inertia:

The motor rotor inertia (J motor) was estimated based on the standard inertia matching principle for small-scale mechatronic systems. It is assumed to be approximately 10% of the load inertia (J load).

J screw = ½ (m screw) r^2 = ½ . 0.897 . (32.5 x (10) ^-3)^2 = 4.73728 x 10^-4 (kg.m^2)

J motor = 10% J screw = 4.73728 x 10^-5 (kg.m^2)

Total system inertia = j load + j motor = 5.211 x 10^-4 (kg.m^2)

Efficiency = 40% = 0.4

F = mg = 0.004 x 9.81 = 0.03924 N

Torque during motion phases:

Lead torque:

Tl = Fl / (efficiency x 2 pi pitch) = 0.03924 / (0.4 x 2 x pi x 0.0262) = 0.5959 N.m

Torque motor:

Torque due to acceleration = (j total x angular acceleration) + Tl = (5.211 x 10^-4 x 34.1) + 0.5959 = 0.614 N.m

Constant speed torque = (j total x angular acceleration) + Tl = 0.5959 N.m

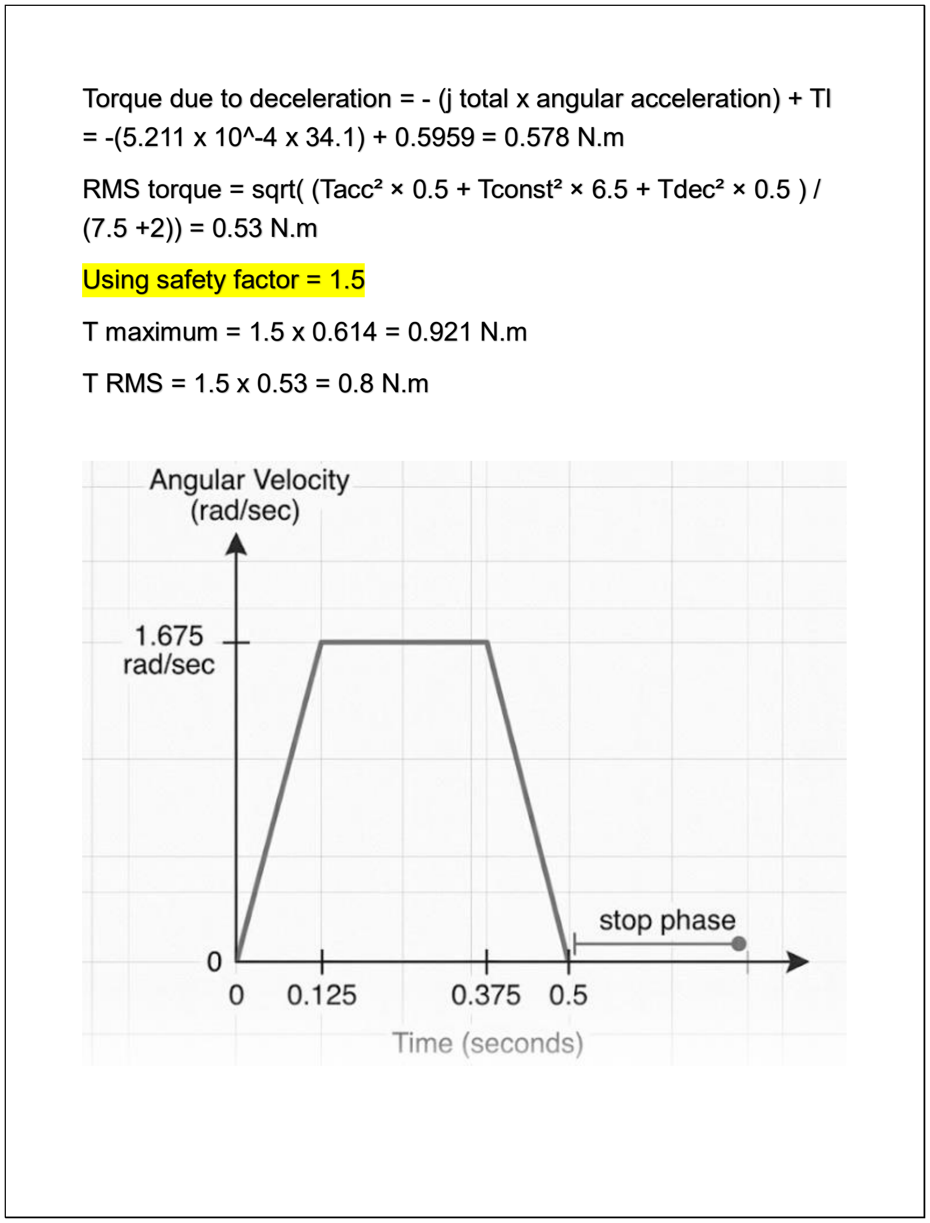
[picture p43: page 34]

Torque due to deceleration = - (j total x angular acceleration) + Tl = -(5.211 x 10^-4 x 34.1) + 0.5959 = 0.578 N.m

RMS torque = sqrt( (Tacc² × 0.5 + Tconst² × 6.5 + Tdec² × 0.5 ) / (7.5 +2)) = 0.53 N.m

Using safety factor = 1.5

T maximum = 1.5 x 0.614 = 0.921 N.m

T RMS = 1.5 x 0.53 = 0.8 N.m

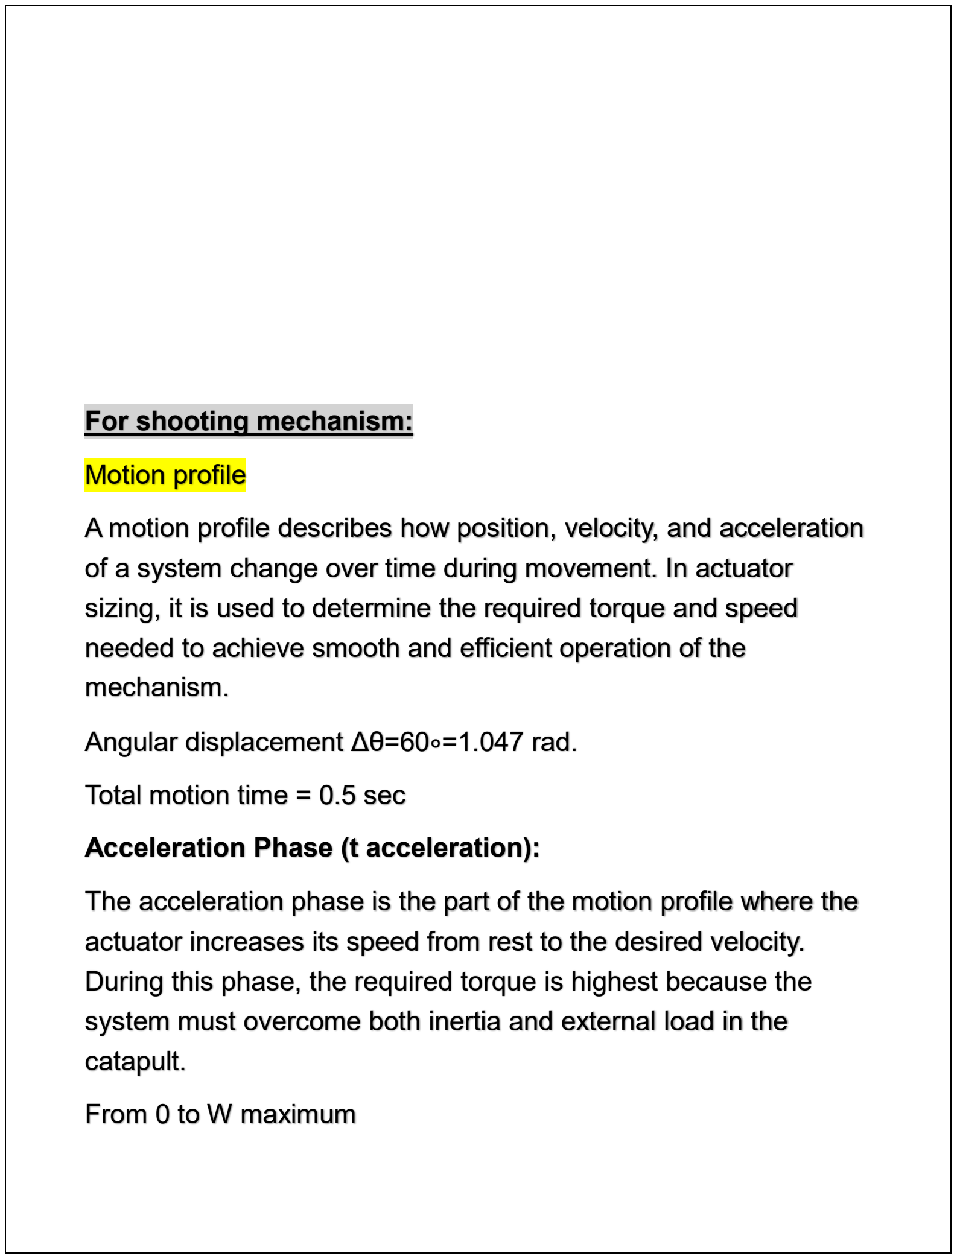
[picture p44: page 35]

For shooting mechanism:

Motion profile

A motion profile describes how position, velocity, and acceleration of a system change over time during movement. In actuator sizing, it is used to determine the required torque and speed needed to achieve smooth and efficient operation of the mechanism.

Angular displacement Δθ=60∘=1.047 rad.

Total motion time = 0.5 sec

Acceleration Phase (t acceleration):

The acceleration phase is the part of the motion profile where the actuator increases its speed from rest to the desired velocity. During this phase, the required torque is highest because the system must overcome both inertia and external load in the catapult.

From 0 to W maximum

- Duration: 0.125 sec

Constant Velocity Phase (t constant):

The constant velocity phase is the part of the motion profile where the actuator moves at a steady speed with zero acceleration. During this phase, the required torque is mainly used to overcome external load since inertia effects are minimal.

- Duration: 0.25 sec

Deceleration Phase (t deceleration):

The deceleration phase is the part of the motion profile where the actuator reduces its speed from the set velocity back to rest. During this phase, torque is applied in the opposite direction to control and stop the motion smoothly while overcoming the system’s inertia and external loads.

From W maximum to 0

- Duration: 0.125 sec

System Synchronization and Dwell Time:

System synchronization and dwell time refer to the coordination of different parts of the system and the intentional pause between motions. Dwell time allows the mechanism to remain in a fixed position for a short period, ensuring proper timing between actions such as loading, holding, and releasing in the catapult system.

- T dwell = 9 sec

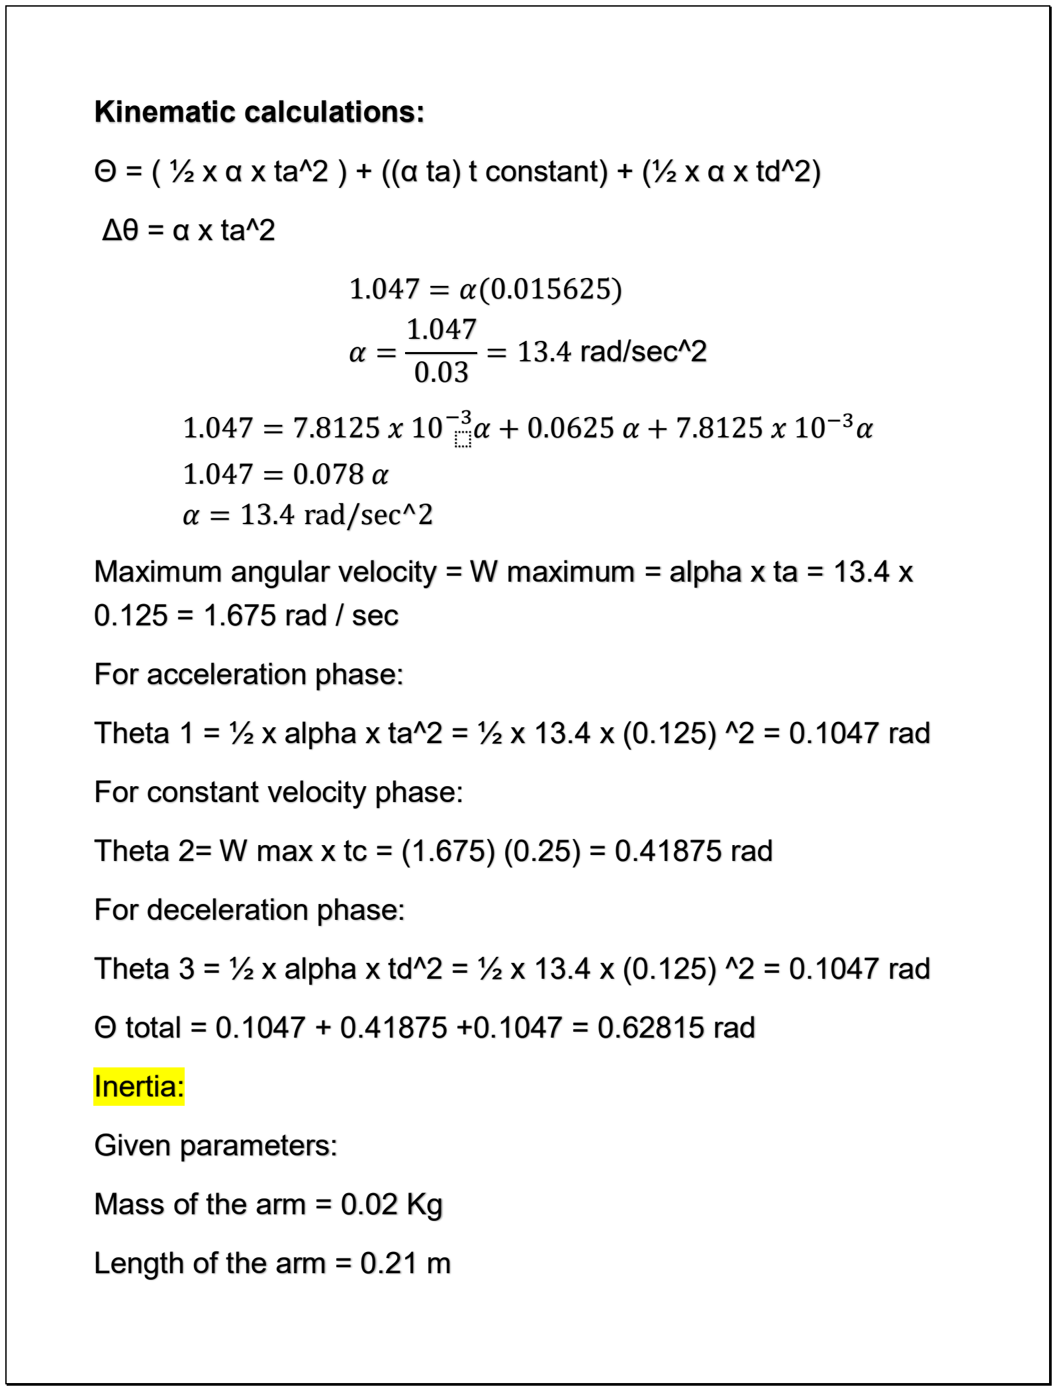
[picture p45: page 37]

Kinematic calculations:

Θ = ( ½ x α x ta^2 ) + ((α ta) t constant) + (½ x α x td^2)

Δθ = α x ta^2

1.047 = α(0.015625)

α =

1.047
0.03 = 13.4 rad/sec^2

1.047 = 7.8125 x 10 ⬚α

−3 + 0.0625 α + 7.8125 x 10⁻³α

1.047 = 0.078 α
α = 13.4 rad/sec^2

Maximum angular velocity = W maximum = alpha x ta = 13.4 x 0.125 = 1.675 rad / sec

For acceleration phase:

Theta 1 = ½ x alpha x ta^2 = ½ x 13.4 x (0.125) ^2 = 0.1047 rad

For constant velocity phase:

Theta 2= W max x tc = (1.675) (0.25) = 0.41875 rad

For deceleration phase:

Theta 3 = ½ x alpha x td^2 = ½ x 13.4 x (0.125) ^2 = 0.1047 rad

Θ total = 0.1047 + 0.41875 +0.1047 = 0.62815 rad

Inertia:

Given parameters:

Mass of the arm = 0.02 Kg

Length of the arm = 0.21 m

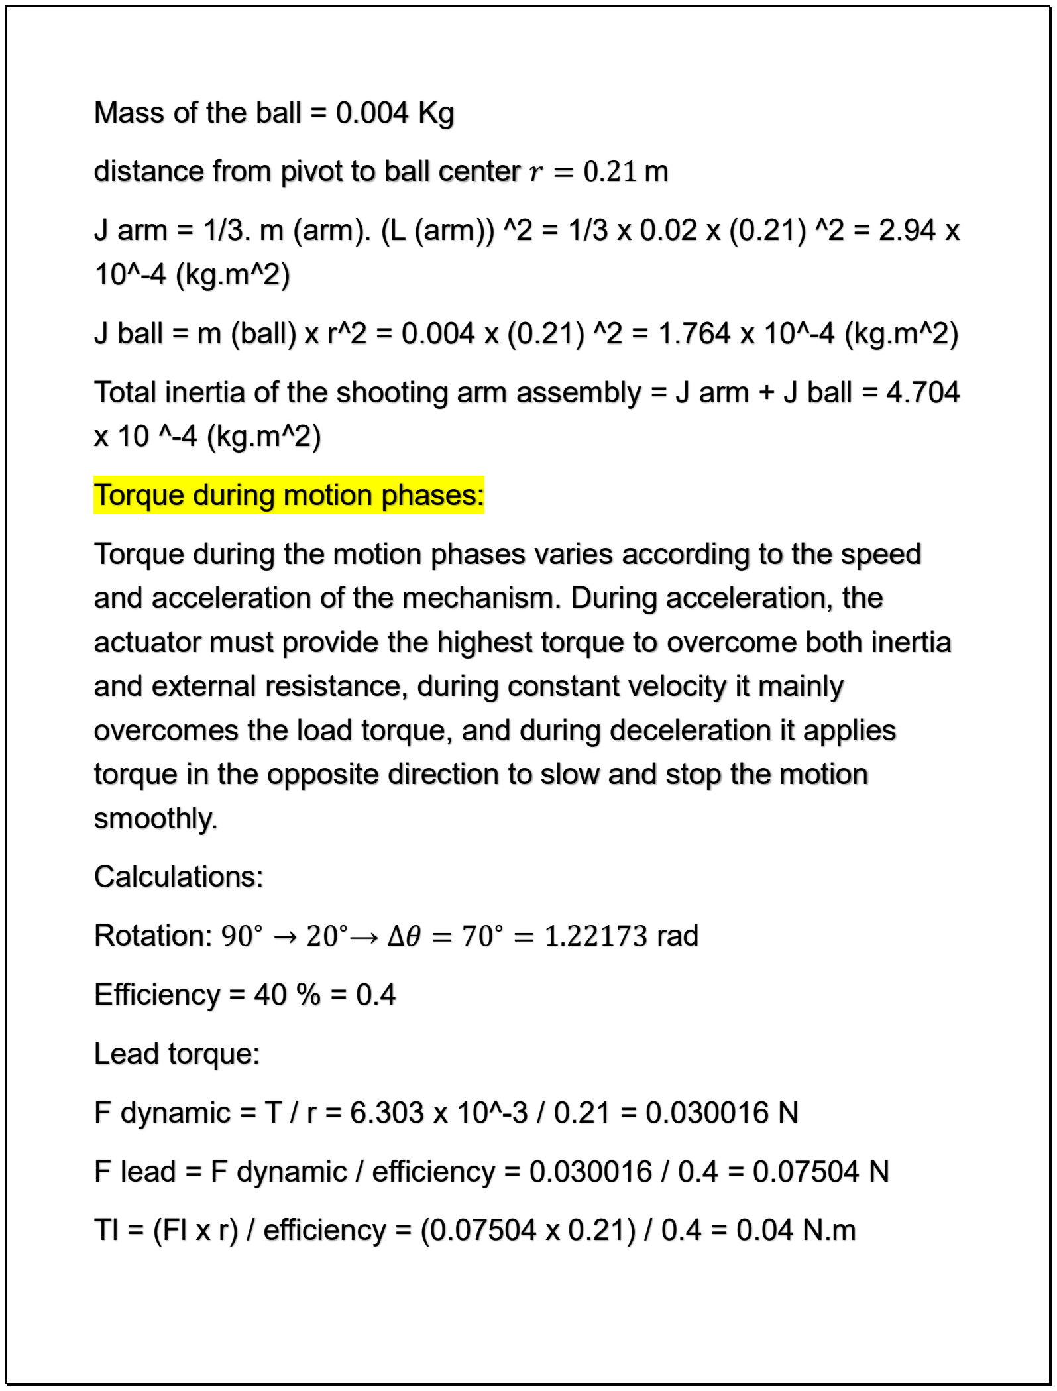
[picture p46: page 38]

Mass of the ball = 0.004 Kg

distance from pivot to ball center r = 0.21 m

J arm = 1/3. m (arm). (L (arm)) ^2 = 1/3 x 0.02 x (0.21) ^2 = 2.94 x 10^-4 (kg.m^2)

J ball = m (ball) x r^2 = 0.004 x (0.21) ^2 = 1.764 x 10^-4 (kg.m^2)

Total inertia of the shooting arm assembly = J arm + J ball = 4.704 x 10 ^-4 (kg.m^2)

Torque during motion phases:

Torque during the motion phases varies according to the speed and acceleration of the mechanism. During acceleration, the actuator must provide the highest torque to overcome both inertia and external resistance, during constant velocity it mainly overcomes the load torque, and during deceleration it applies torque in the opposite direction to slow and stop the motion smoothly.

Calculations:

Rotation: 90∘ → 20∘→ Δθ = 70∘ = 1.22173 rad

Efficiency = 40 % = 0.4

Lead torque:

F dynamic = T / r = 6.303 x 10^-3 / 0.21 = 0.030016 N

F lead = F dynamic / efficiency = 0.030016 / 0.4 = 0.07504 N

Tl = (Fl x r) / efficiency = (0.07504 x 0.21) / 0.4 = 0.04 N.m

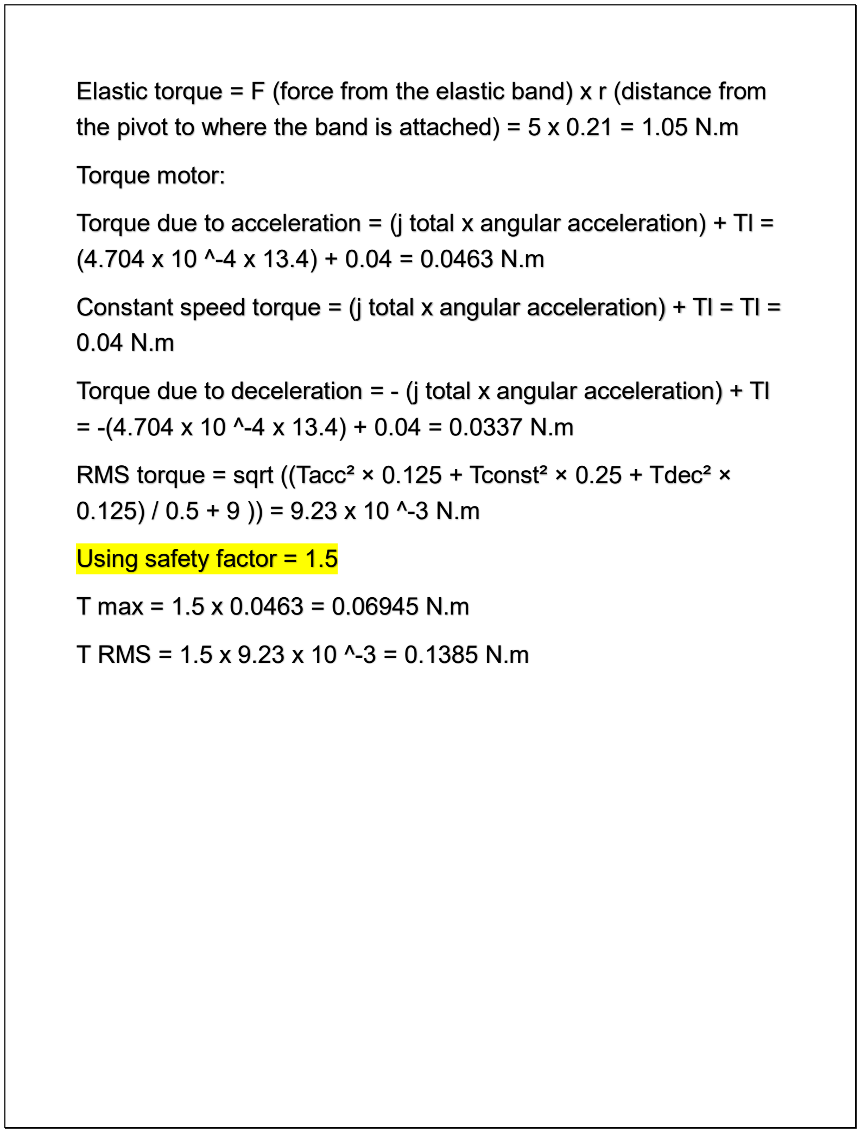
[picture p47: page 39]

Elastic torque = F (force from the elastic band) x r (distance from the pivot to where the band is attached) = 5 x 0.21 = 1.05 N.m

Torque motor:

Torque due to acceleration = (j total x angular acceleration) + Tl = (4.704 x 10 ^-4 x 13.4) + 0.04 = 0.0463 N.m

Constant speed torque = (j total x angular acceleration) + Tl = Tl = 0.04 N.m

Torque due to deceleration = - (j total x angular acceleration) + Tl = -(4.704 x 10 ^-4 x 13.4) + 0.04 = 0.0337 N.m

RMS torque = sqrt ((Tacc² × 0.125 + Tconst² × 0.25 + Tdec² × 0.125) / 0.5 + 9 )) = 9.23 x 10 ^-3 N.m

Using safety factor = 1.5

T max = 1.5 x 0.0463 = 0.06945 N.m

T RMS = 1.5 x 9.23 x 10 ^-3 = 0.1385 N.m

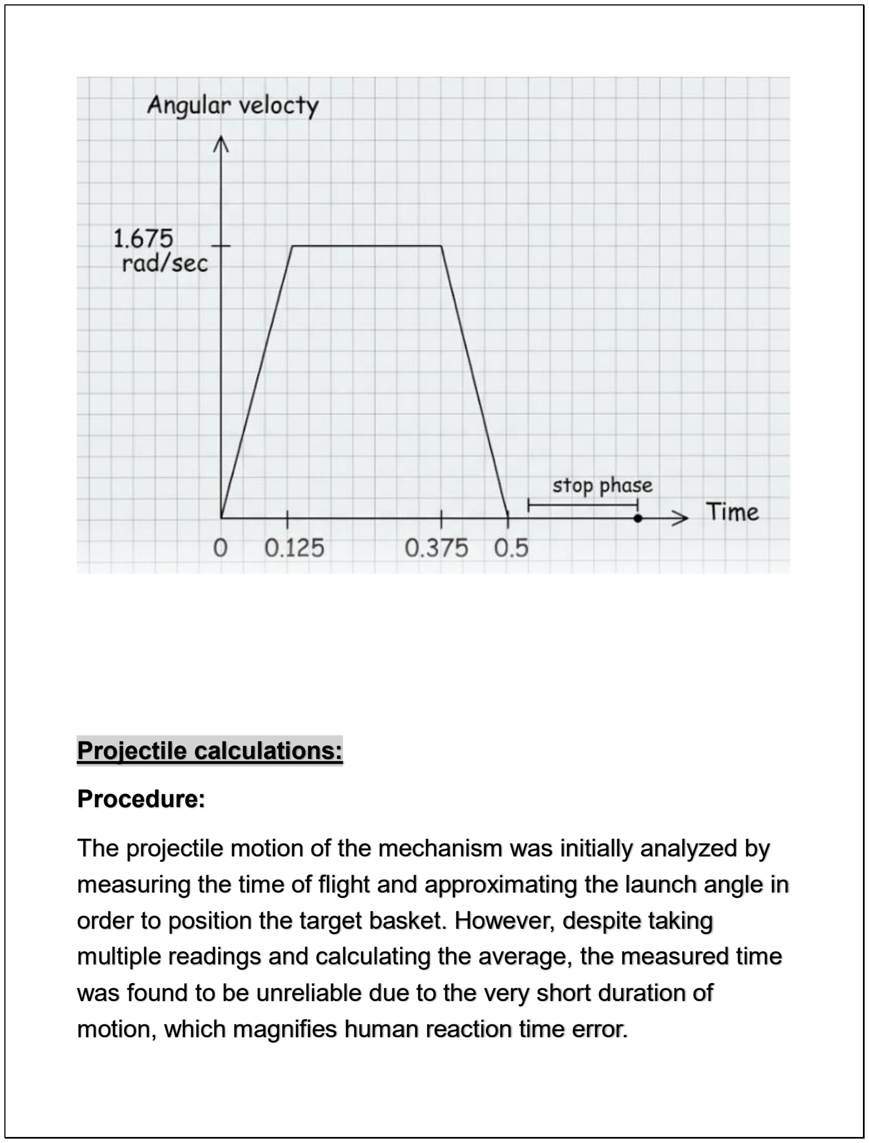
[picture p48: page 40]

Projectile calculations:

Procedure:

The projectile motion of the mechanism was initially analyzed by measuring the time of flight and approximating the launch angle in order to position the target basket. However, despite taking multiple readings and calculating the average, the measured time was found to be unreliable due to the very short duration of motion, which magnifies human reaction time error.

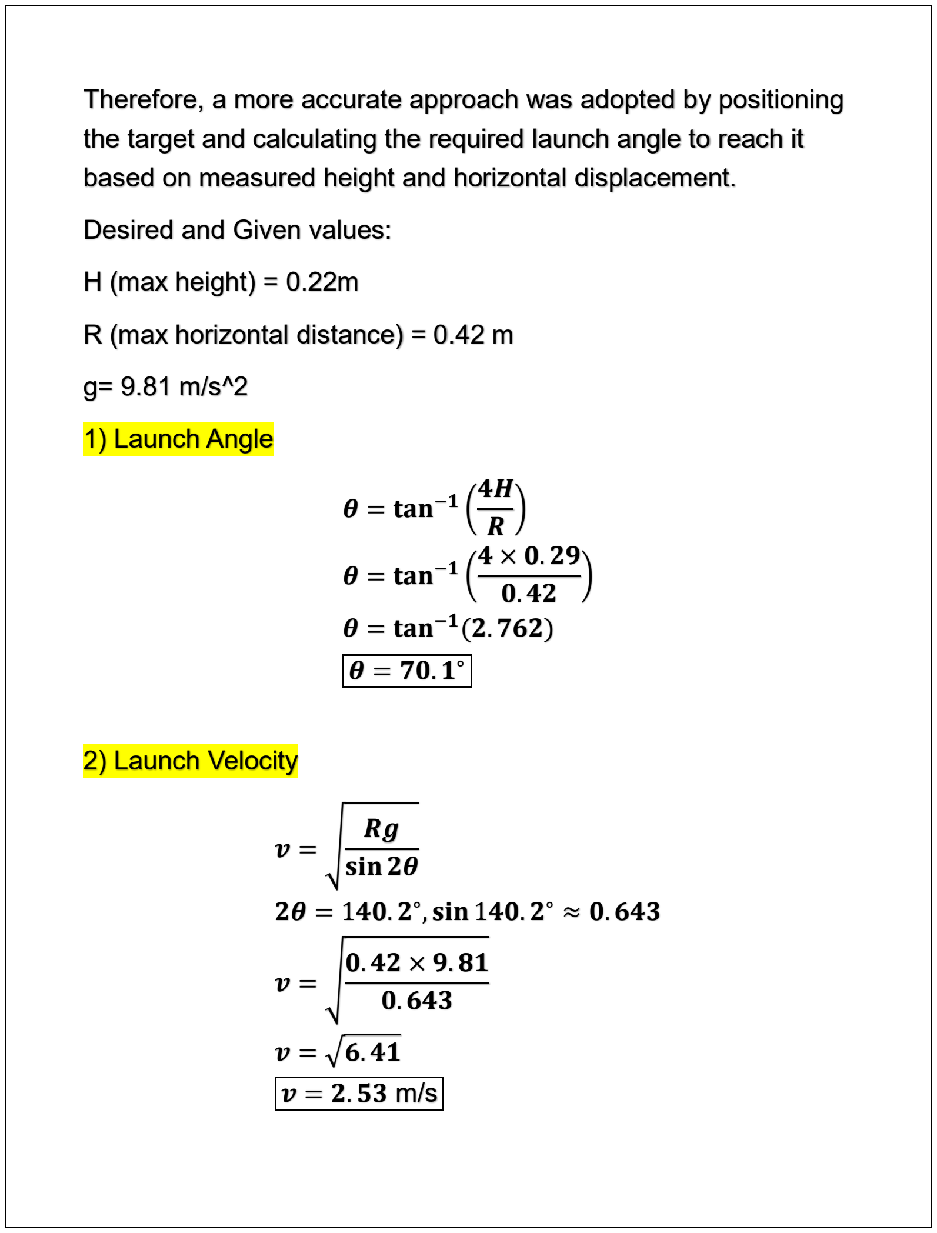
[picture p49: page 41]

Therefore, a more accurate approach was adopted by positioning the target and calculating the required launch angle to reach it based on measured height and horizontal displacement.

Desired and Given values:

H (max height) = 0.22m

R (max horizontal distance) = 0.42 m

g= 9.81 m/s^2

1) Launch Angle

θ = tan⁻1

൬

4H
R

൰

θ = tan⁻1

൬

4 × 0. 29
0. 42 ൰

θ = tan⁻1
(2. 762)
θ = 70. 1

∘

2) Launch Velocity

v = ඨ
Rg
sin 2θ
2θ = 140. 2

∘
, sin 140. 2

∘ ≈ 0. 643
v = ඨ
0. 42 × 9. 81
0. 643
v = ඥ6. 41

v = 2. 53 m/s

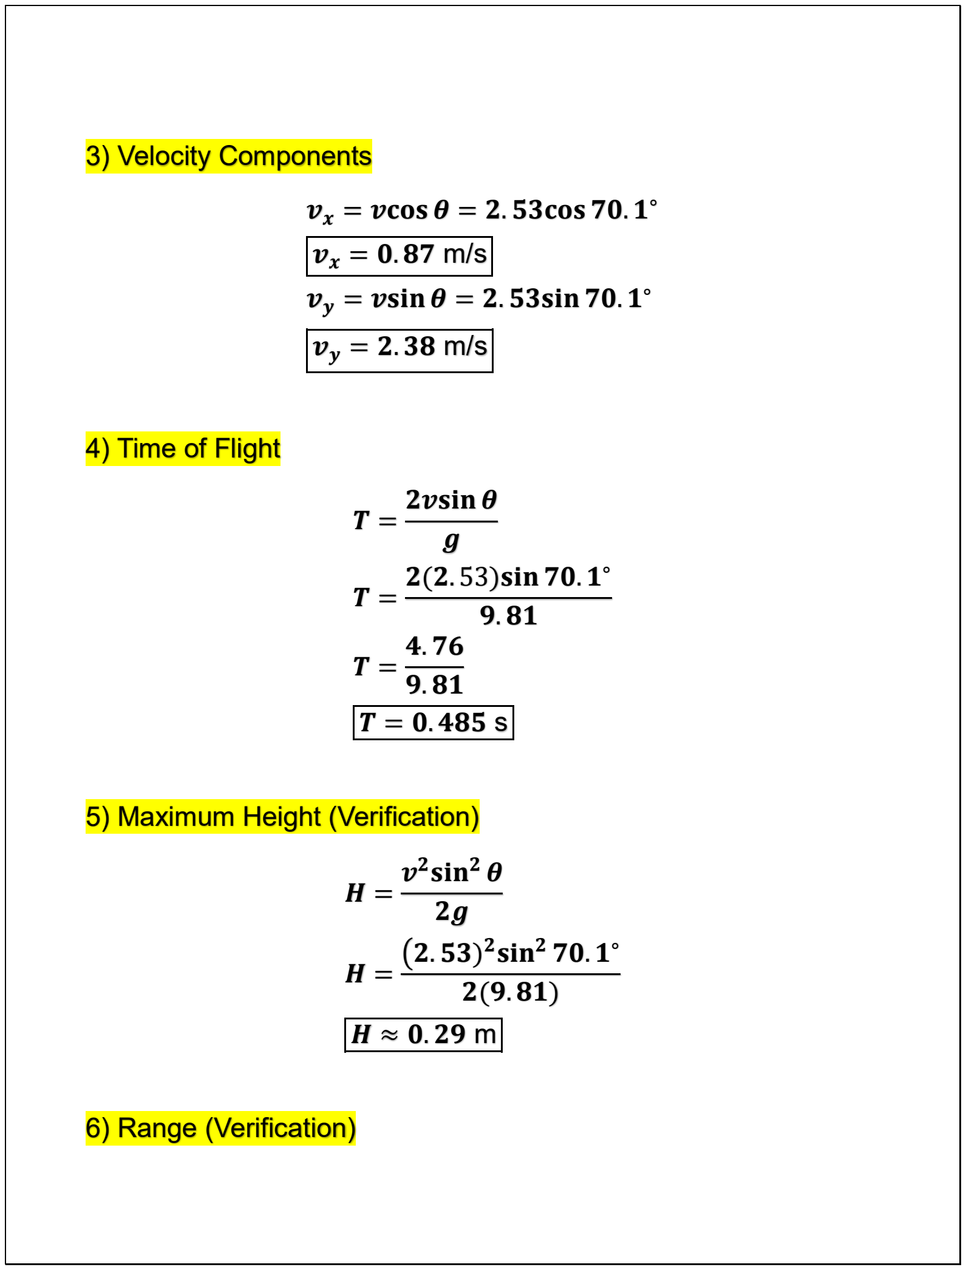
[picture p50: page 42]

3) Velocity Components

vx = vcos θ = 2. 53cos 70. 1

∘

vx = 0. 87 m/s
vy = vsin θ = 2. 53sin 70. 1

∘

vy = 2. 38 m/s

4) Time of Flight

T =

2vsin θ
g

T =

2(2. 53)sin 70. 1

∘
9. 81

T =

4. 76
9. 81
T = 0. 485 s
5) Maximum Height (Verification)

H =

v

2

sin2 θ
2g

H =

൫2. 53)

2

sin2 70. 1

∘
2(9. 81)
H ≈ 0. 29 m
6) Range (Verification)

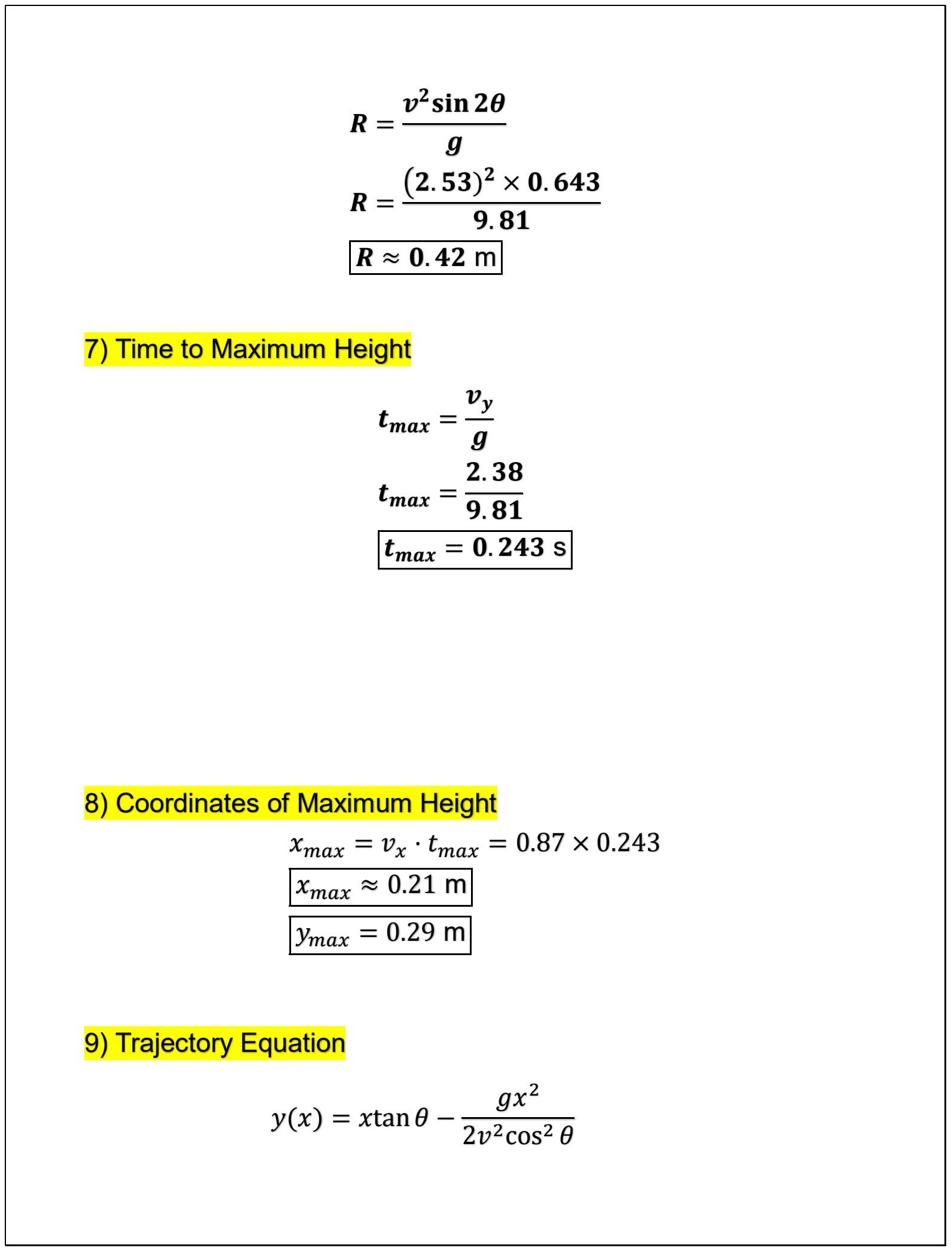
[picture p51: page 43]

R =

v

2
sin2θ
g

R =

൫2. 53)

2 × 0. 643
9. 81
R ≈ 0. 42 m
7) Time to Maximum Height

tmax =

vy
g

tmax =

2. 38
9. 81
tmax = 0. 243 s
8) Coordinates of Maximum Height xmax = vx ⋅ tmax = 0.87 × 0.243 xmax ≈ 0.21 m

ymax = 0.29 m

9) Trajectory Equation

y(x) = xtan θ −

gx

2
2v

2cos² θ

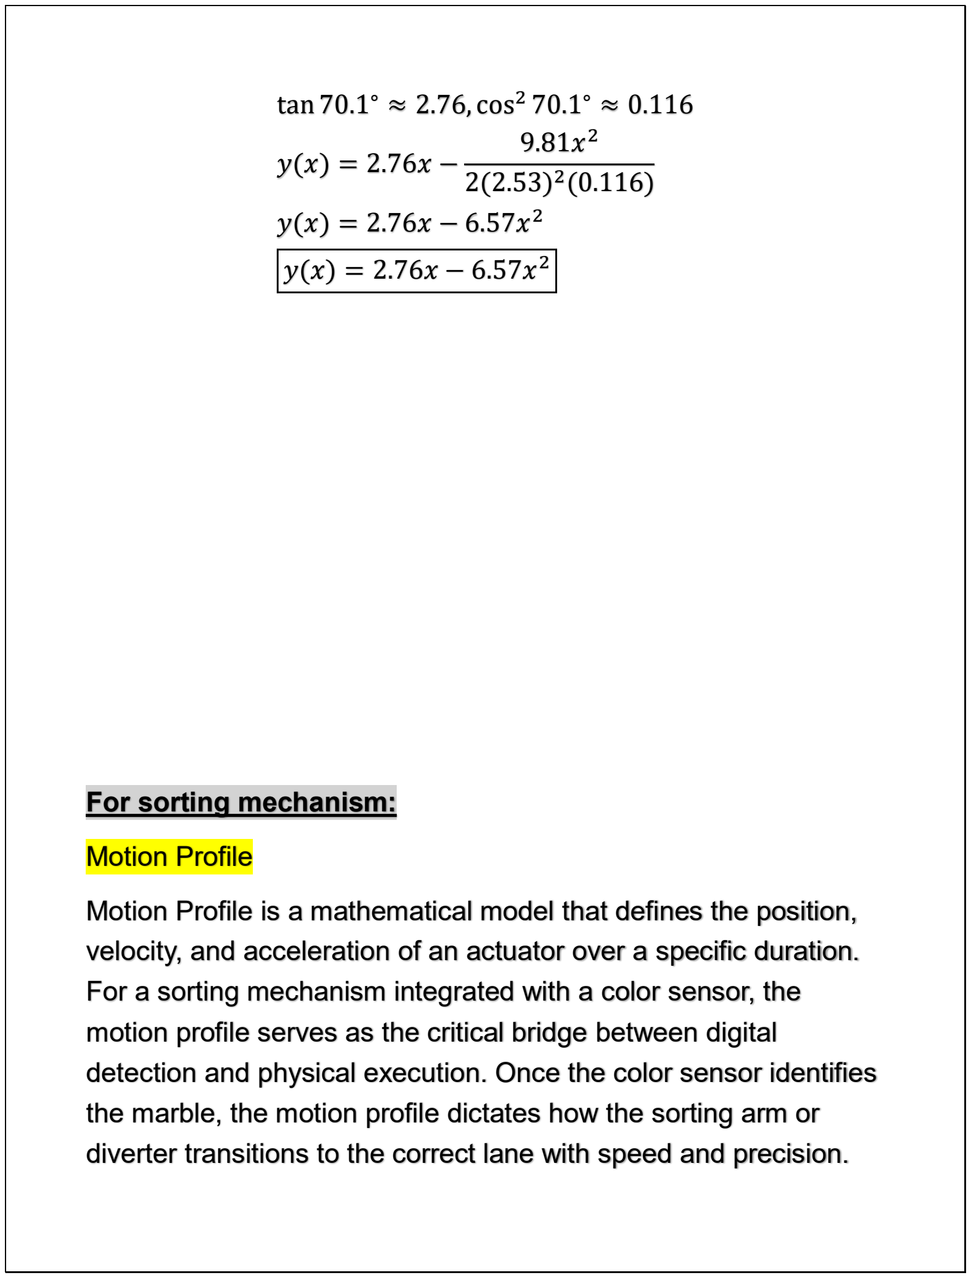
[picture p52: page 44]

tan 70.1

∘ ≈ 2.76, cos² 70.1

∘ ≈ 0.116

y(x) = 2.76x −

9.81x

2
2(2.53)

2(0.116)
y(x) = 2.76x − 6.57x

2

y(x) = 2.76x − 6.57x

2

For sorting mechanism:

Motion Profile

Motion Profile is a mathematical model that defines the position, velocity, and acceleration of an actuator over a specific duration. For a sorting mechanism integrated with a color sensor, the motion profile serves as the critical bridge between digital detection and physical execution. Once the color sensor identifies the marble, the motion profile dictates how the sorting arm or diverter transitions to the correct lane with speed and precision.

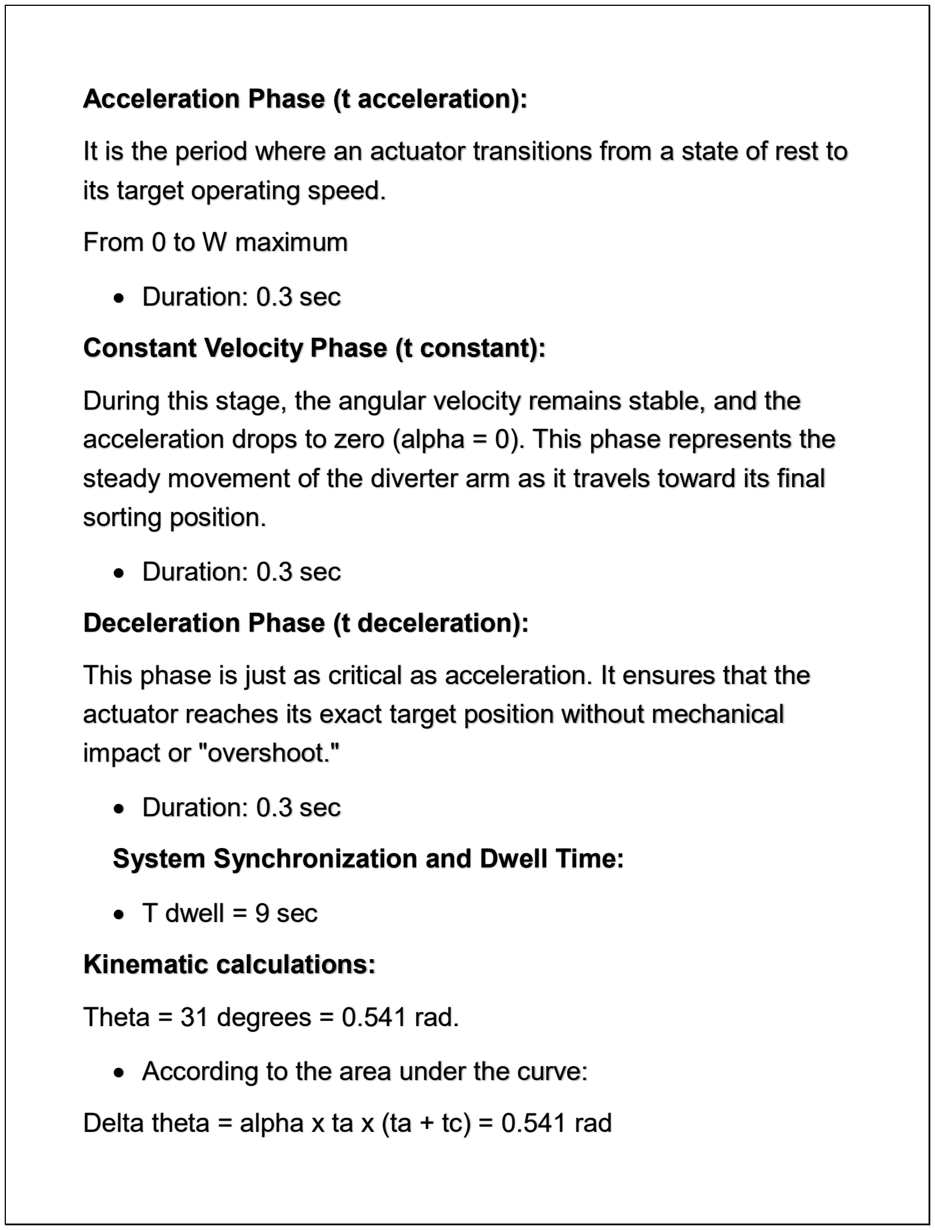
[picture p53: page 45]

Acceleration Phase (t acceleration):

It is the period where an actuator transitions from a state of rest to its target operating speed.

From 0 to W maximum

- Duration: 0.3 sec

Constant Velocity Phase (t constant):

During this stage, the angular velocity remains stable, and the acceleration drops to zero (alpha = 0). This phase represents the steady movement of the diverter arm as it travels toward its final sorting position.

- Duration: 0.3 sec

Deceleration Phase (t deceleration):

This phase is just as critical as acceleration. It ensures that the actuator reaches its exact target position without mechanical impact or "overshoot."

- Duration: 0.3 sec

System Synchronization and Dwell Time:

- T dwell = 9 sec

Kinematic calculations:

Theta = 31 degrees = 0.541 rad.

- According to the area under the curve:

Delta theta = alpha x ta x (ta + tc) = 0.541 rad

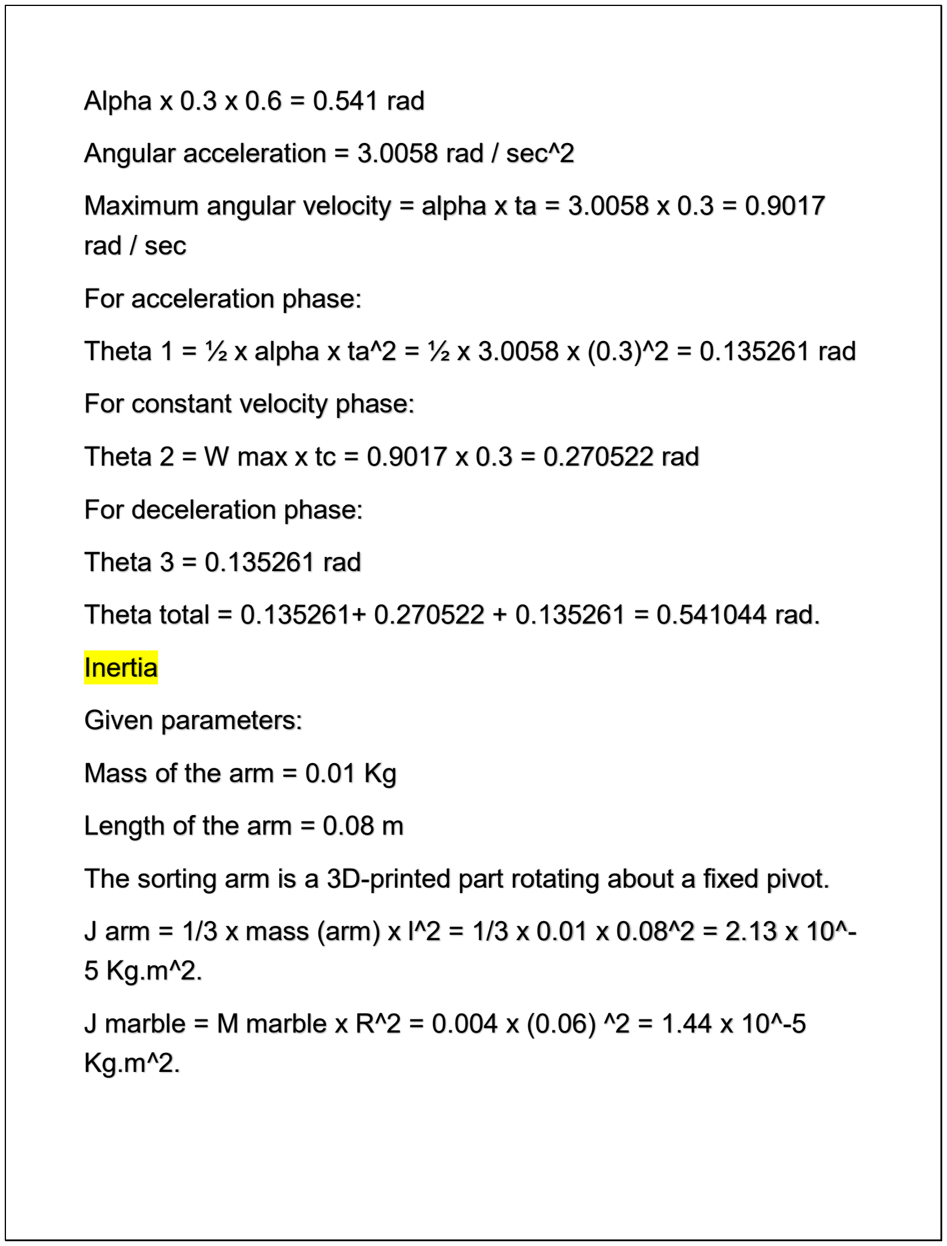
[picture p54: page 46]

Alpha x 0.3 x 0.6 = 0.541 rad

Angular acceleration = 3.0058 rad / sec^2

Maximum angular velocity = alpha x ta = 3.0058 x 0.3 = 0.9017 rad / sec

For acceleration phase:

Theta 1 = ½ x alpha x ta^2 = ½ x 3.0058 x (0.3)^2 = 0.135261 rad

For constant velocity phase:

Theta 2 = W max x tc = 0.9017 x 0.3 = 0.270522 rad

For deceleration phase:

Theta 3 = 0.135261 rad

Theta total = 0.135261+ 0.270522 + 0.135261 = 0.541044 rad.

Inertia

Given parameters:

Mass of the arm = 0.01 Kg

Length of the arm = 0.08 m

The sorting arm is a 3D-printed part rotating about a fixed pivot.

J arm = 1/3 x mass (arm) x l^2 = 1/3 x 0.01 x 0.08^2 = 2.13 x 10^-5 Kg.m^2.

J marble = M marble x R^2 = 0.004 x (0.06) ^2 = 1.44 x 10^-5 Kg.m^2.

(Where R is the distance from the pivot to the point where the marble hits the arm).

J total = J arm + J marble = 2.13 x 10^-5 + 1.44 x 10^-5 = 3.57 x 10^-5 Kg.m^2.

Torque during motion phases:

Torque (T) is the rotational effort required by the servo motor to move the sorting arm through its mission. Torque is not a single, static value; it is a dynamic requirement that changes based on the physics of each phase in the motion profile.

Dynamic torque = angular acceleration x total inertia = 3.0058 x 3.57 x 10^-5 = 1.071 x 10^-4 N.m

Lead torque = dynamic torque / efficiency = 1.071 x 10^-4 / 0.4 = 2.6775 x 10^-4 N.m

Torque motor:

Torque due to acceleration = (j total x angular acceleration) + Tl = ) 3.57 x 10^-5 x 3.0058) + 2.6775 x 10^-4 = 3.7485 x 10^-4 N.m

Constant speed torque = (j total x angular acceleration) + Tl = Tl = 2.6775 x 10^-4 N.m

Torque due to deceleration = -(j total x angular acceleration) + Tl = = -) 3.57 x 10^-5 x 3.0058) + 2.6775 x 10^-4 = 1.6065 x 10^-4 N.m

RMS torque = sqrt ((Tacc² × 0.3 + Tconst² × 0.3 + Tdec² × 0.3) / 0.9 + 9)) = 8.5 x 10^-5 N.m

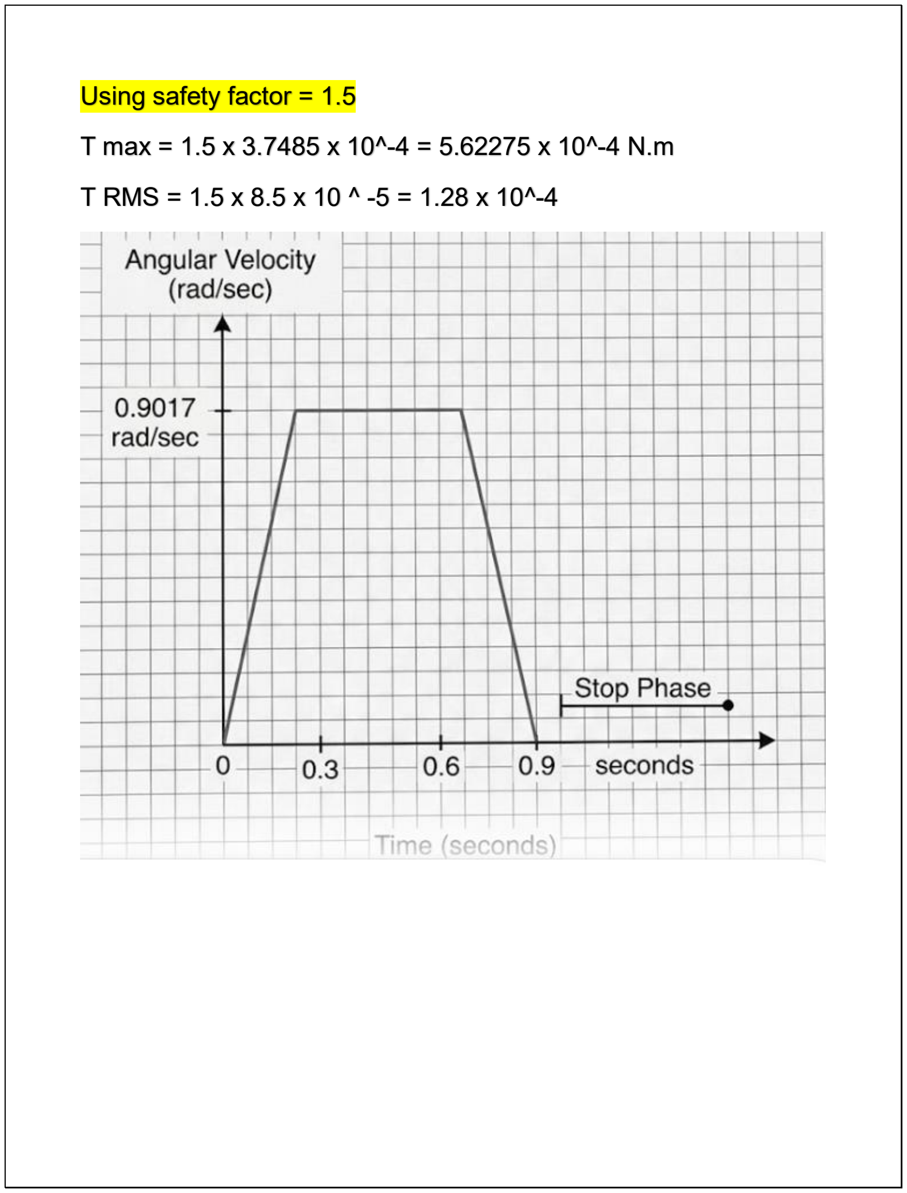
[picture p55: page 48]

Using safety factor = 1.5

T max = 1.5 x 3.7485 x 10^-4 = 5.62275 x 10^-4 N.m

T RMS = 1.5 x 8.5 x 10 ^ -5 = 1.28 x 10^-4

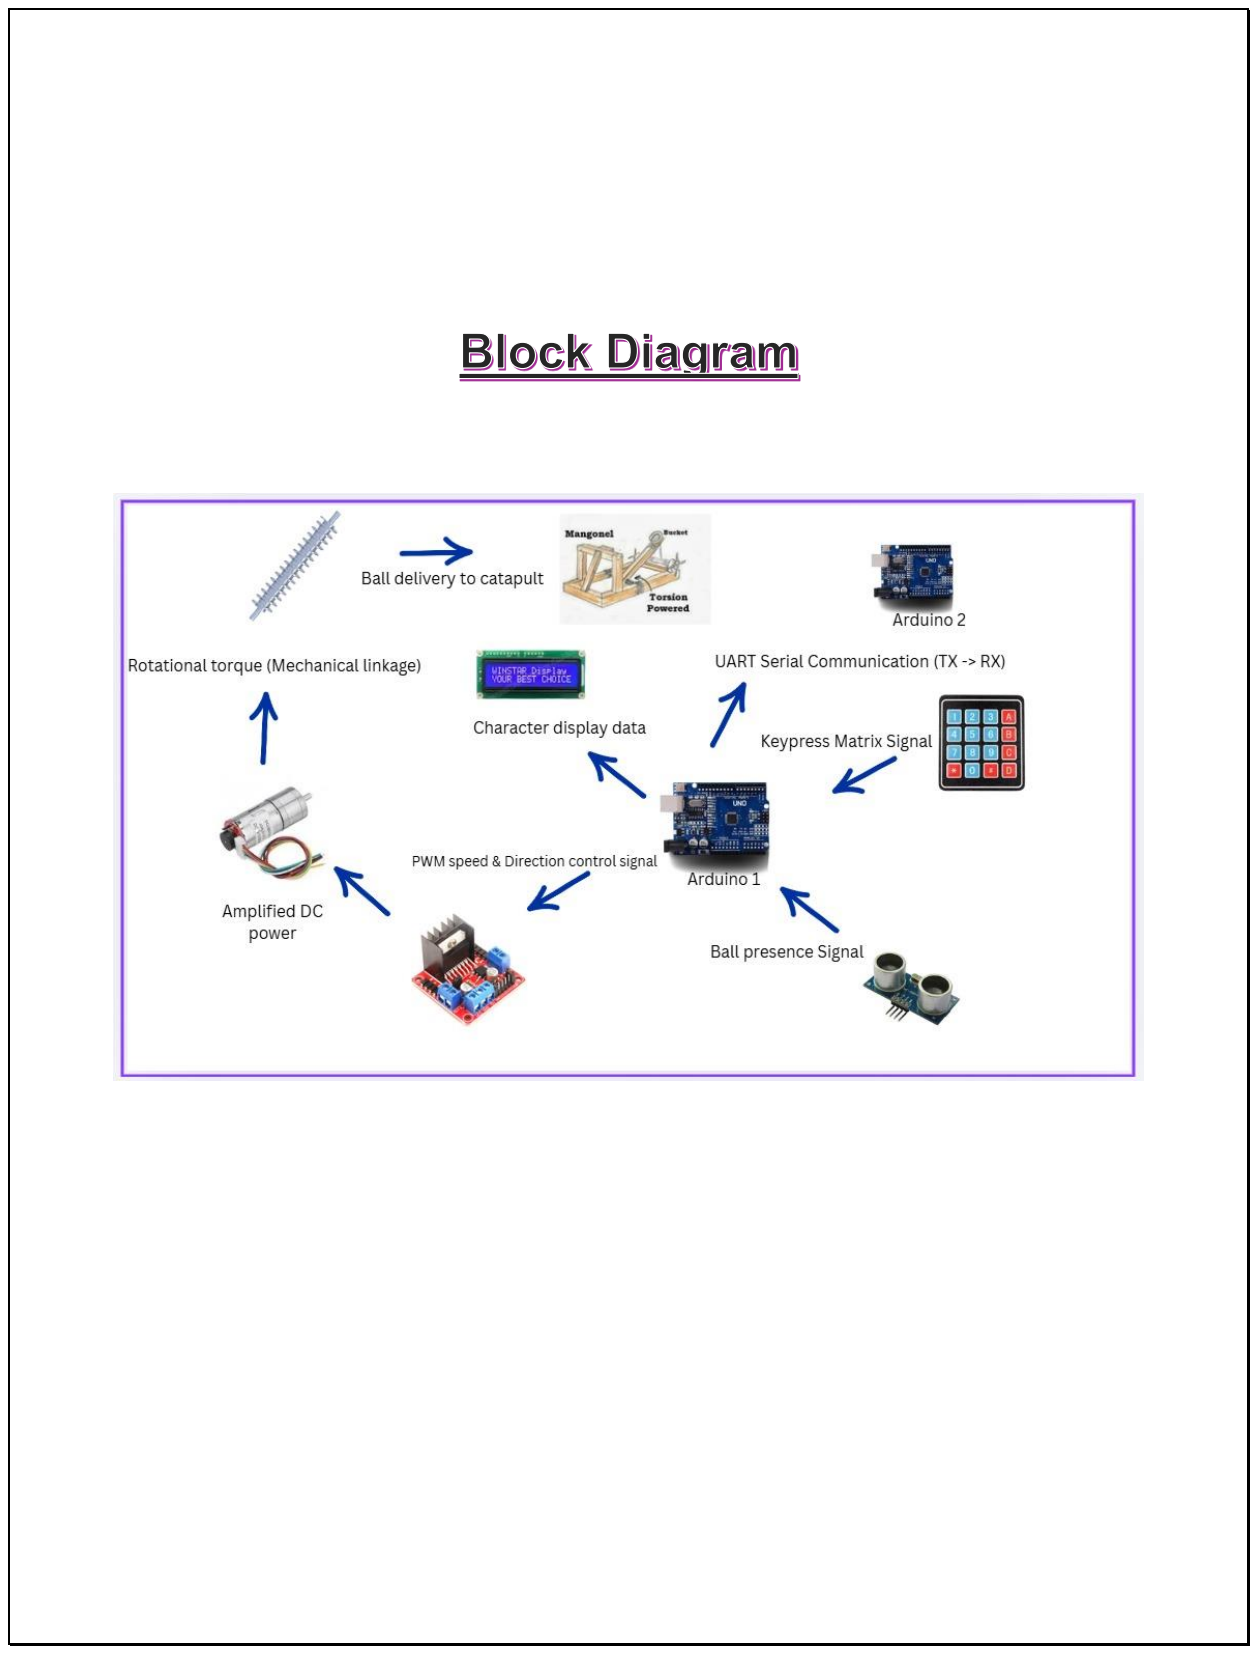
[picture p56: page 49]

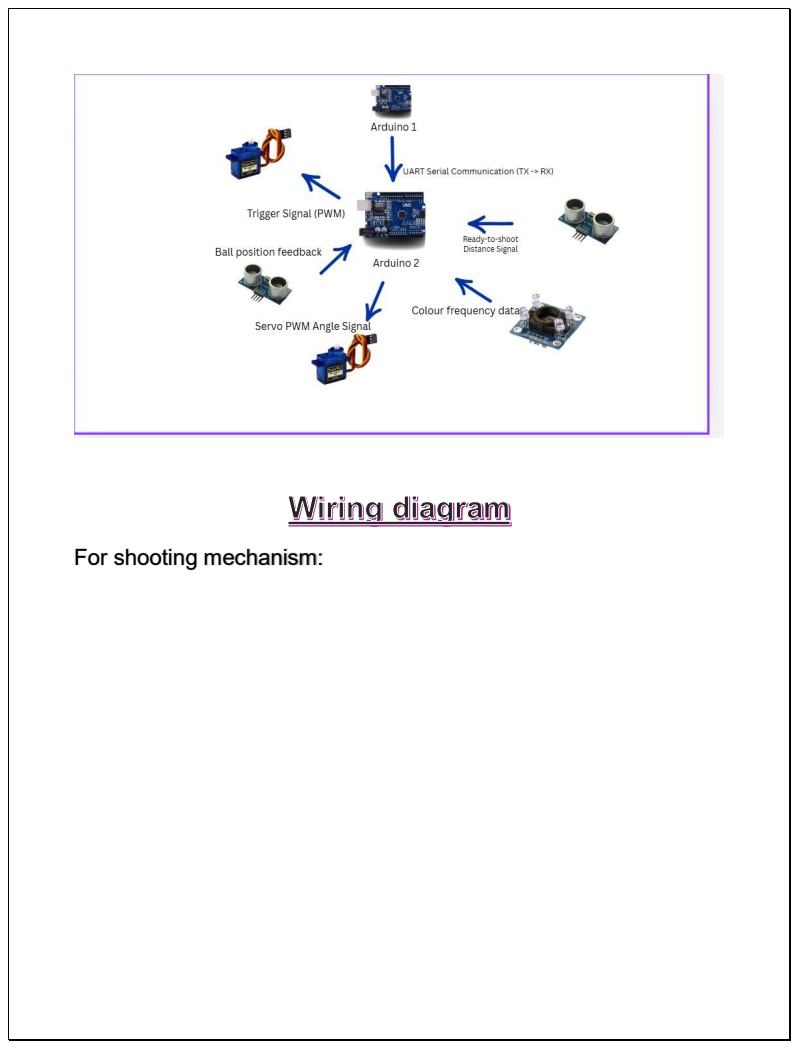
[picture p57: page 50]

For shooting mechanism:

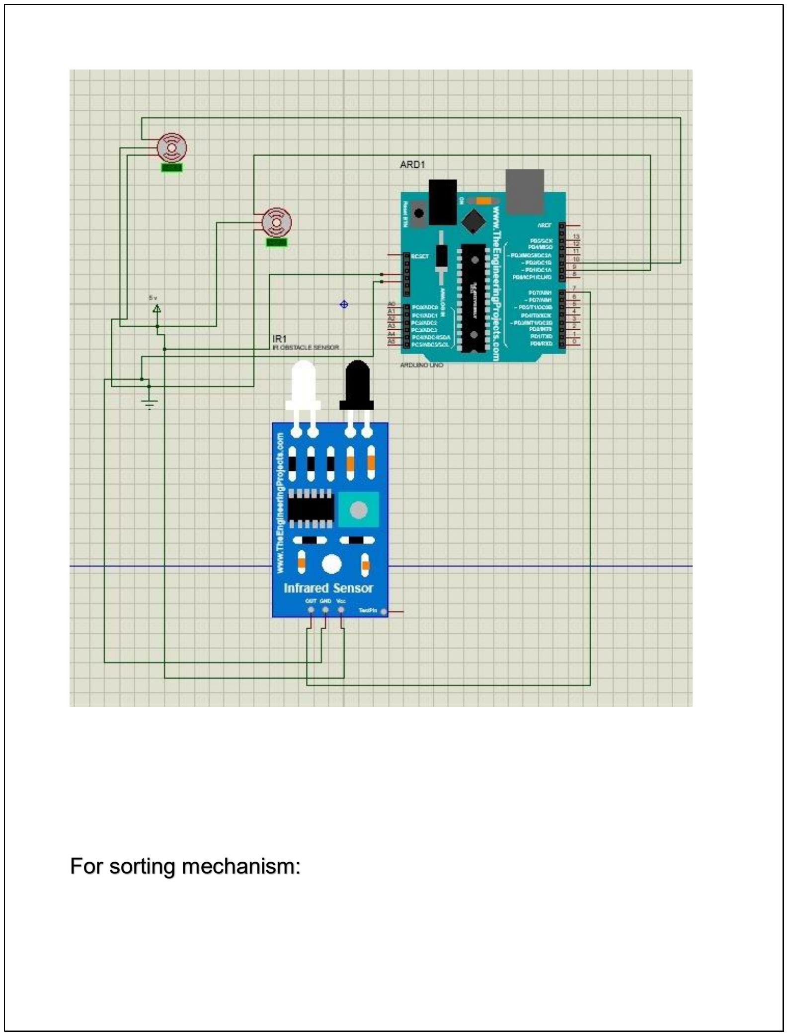
[picture p58: page 51]

For sorting mechanism:

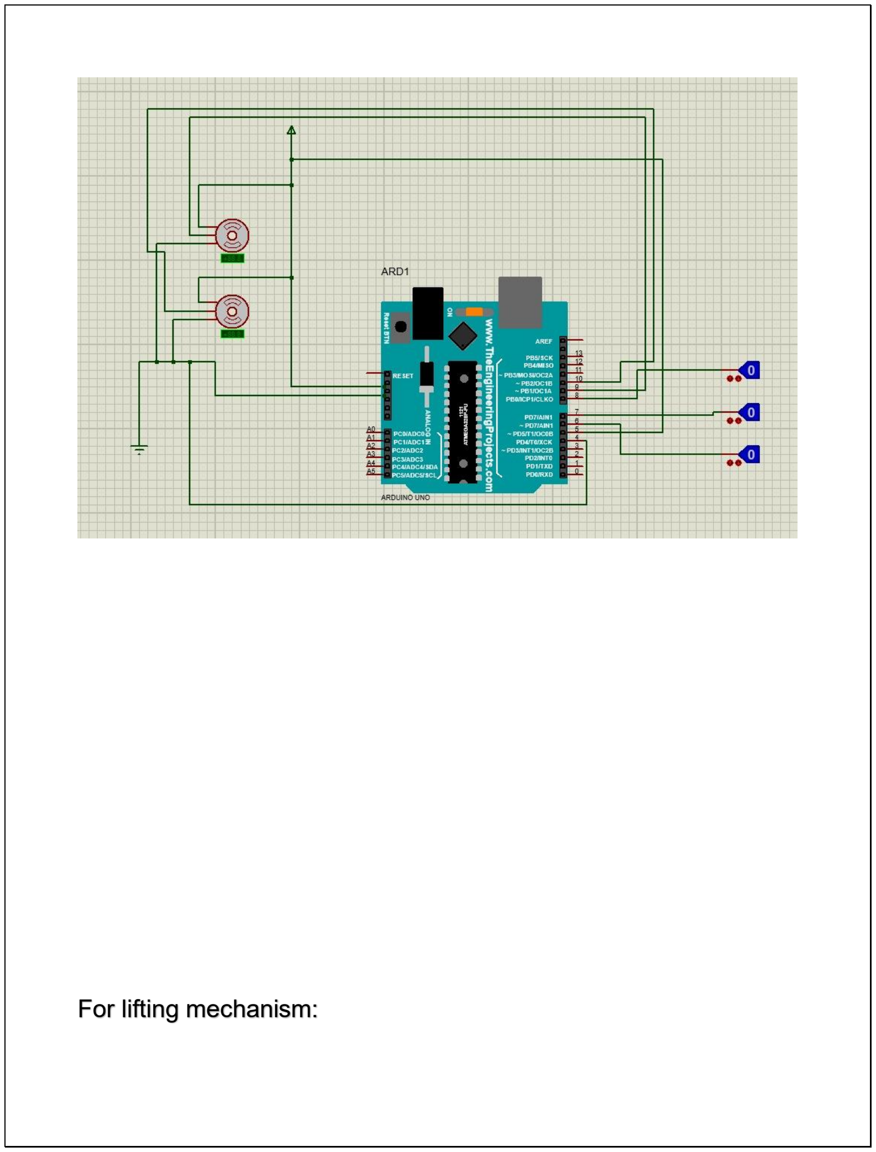
[picture p59: page 52]

For lifting mechanism:

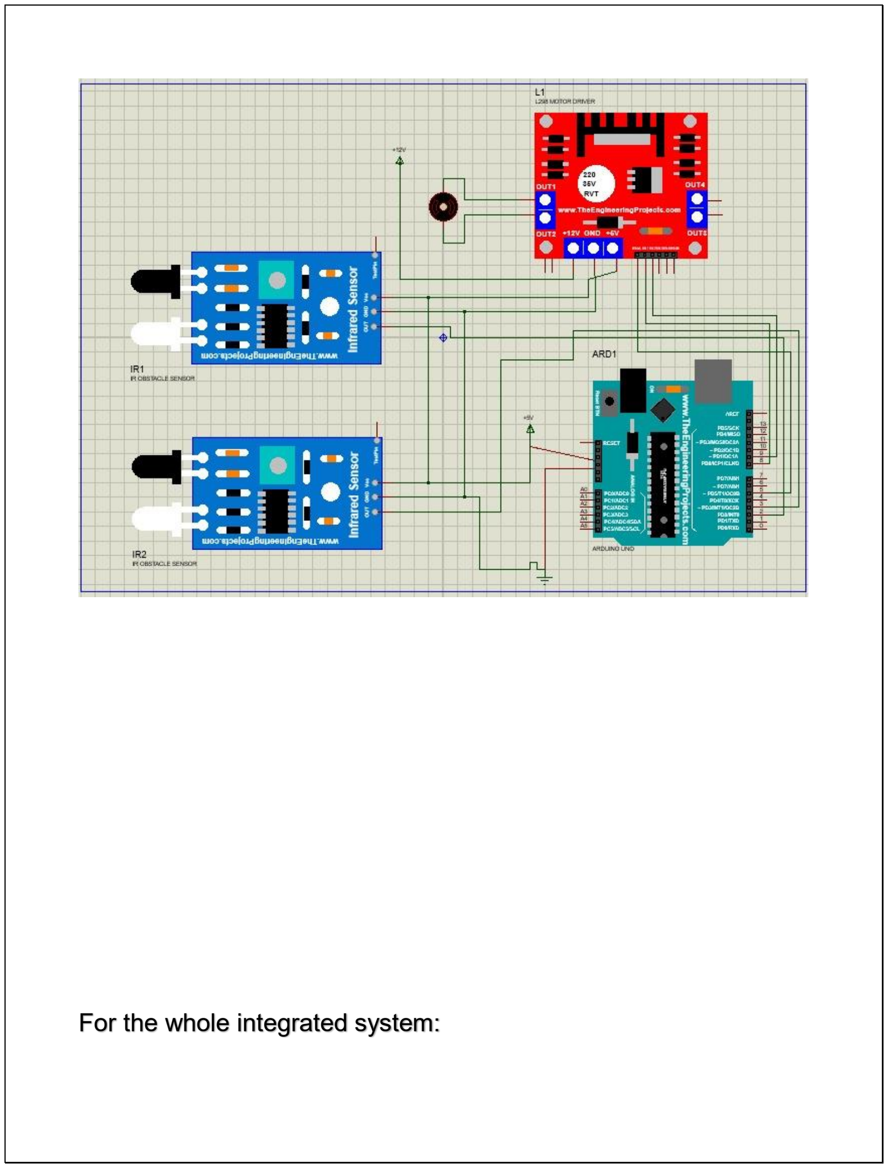
[picture p60: page 53]

For the whole integrated system:

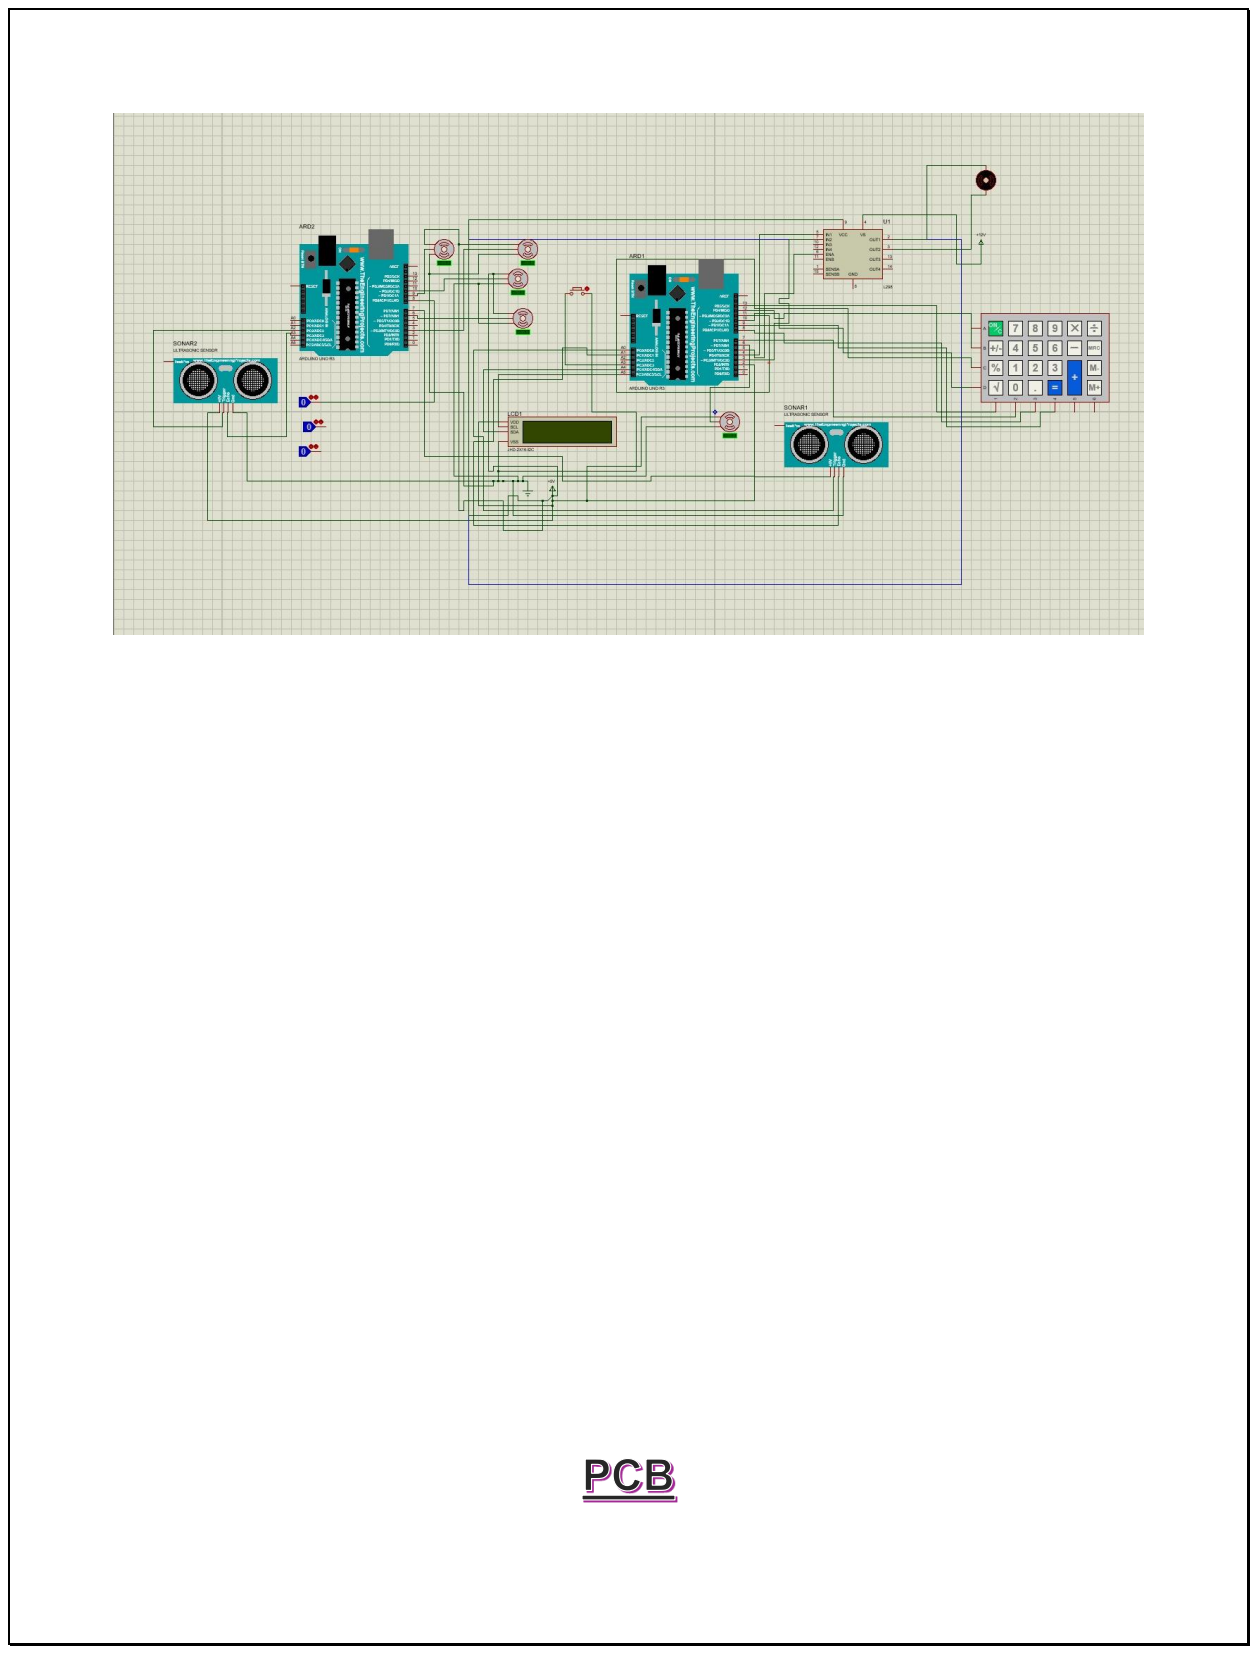
[picture p61: page 54]

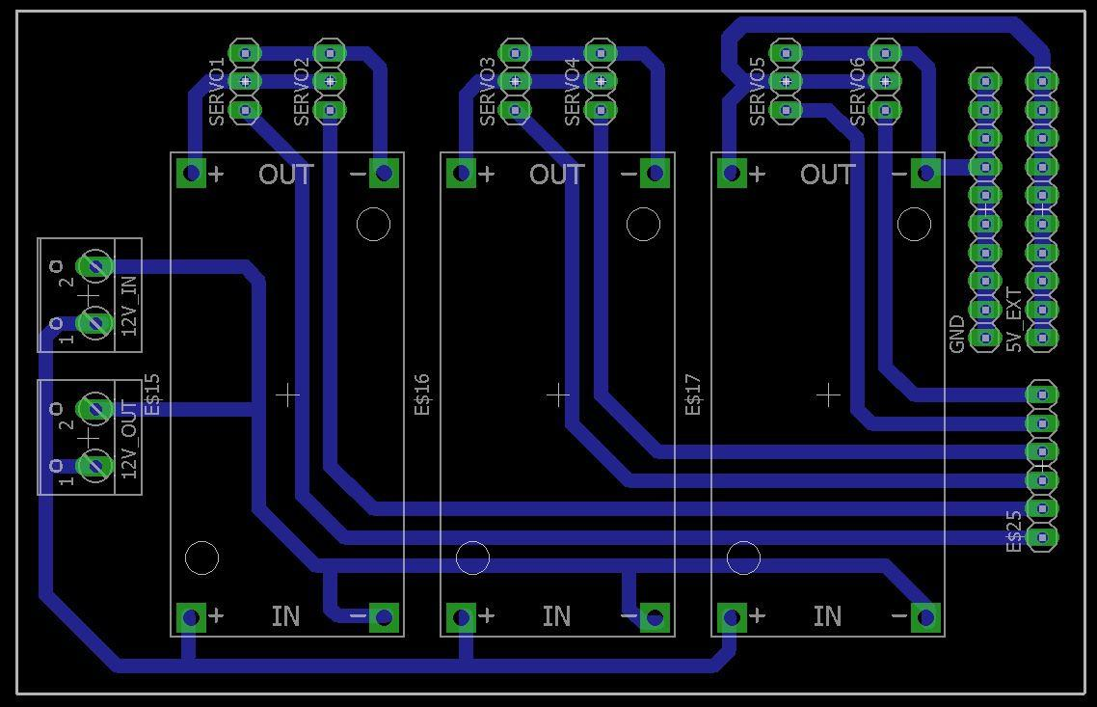
[picture p62: figure]

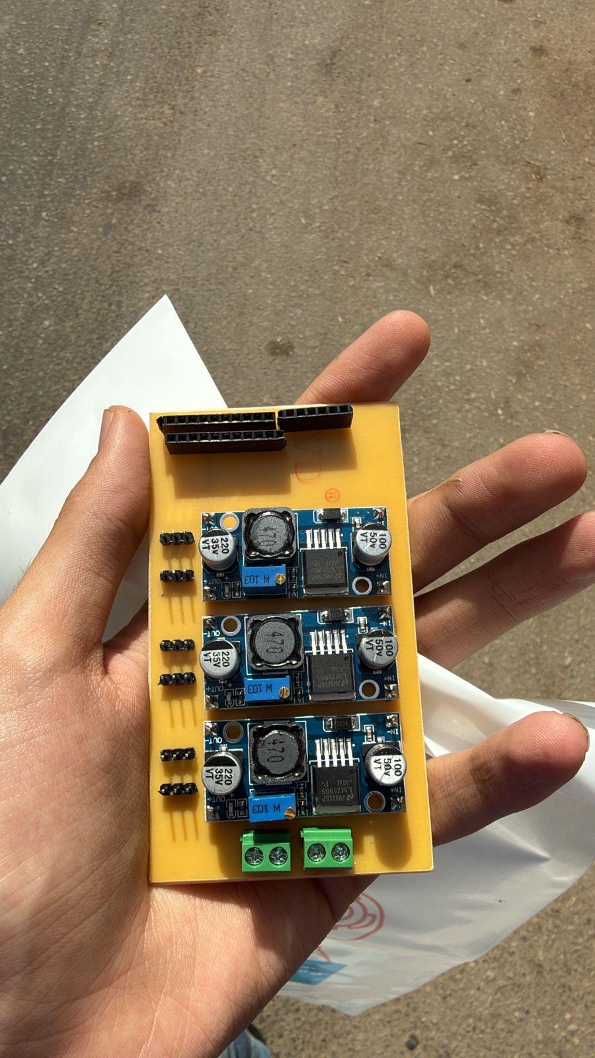
[picture p63: figure]
