malakmarwan/Space-Garden/Mechanical/SRB-26C-5X10.SLDPRT

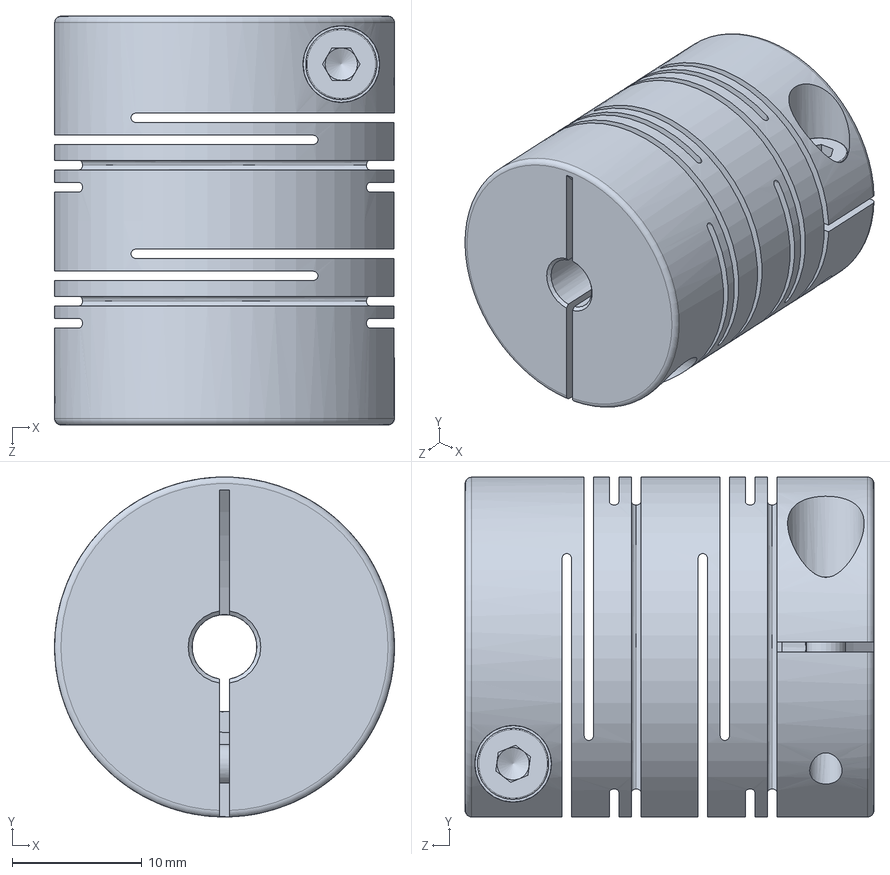
[picture p64: CAD file, 2026-06-09]
Mechanical/SRB-26C-5X10.SLDPRT
26.2 x 26.2 x 31.5 mm
