malakmarwan/Space-Garden/Mechanical/cover el shooting (1).stl

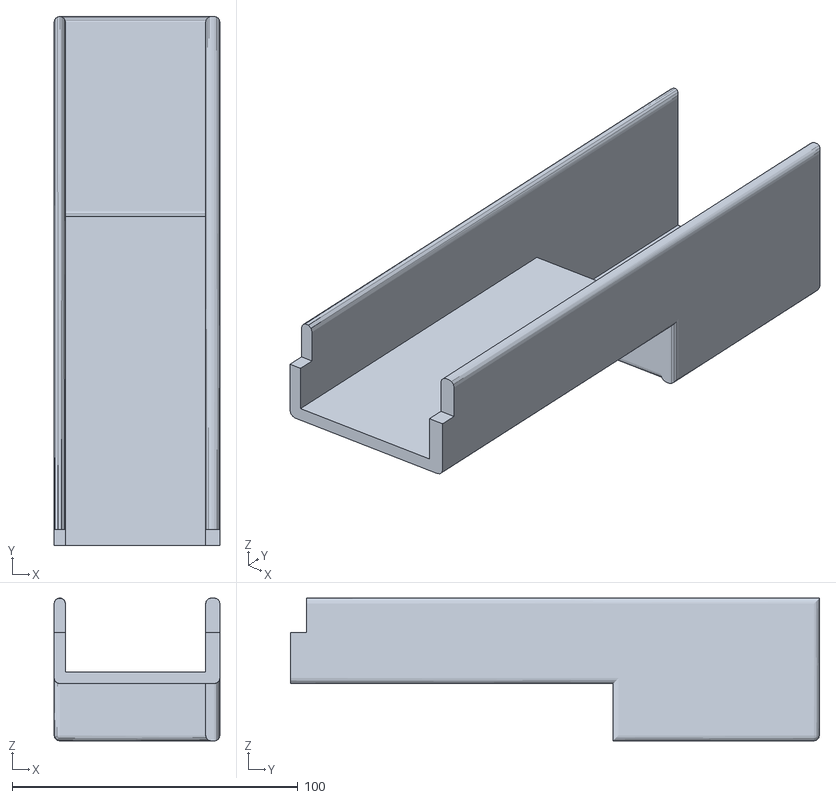
[picture p65: CAD file, 2026-06-09]
Mechanical/cover el shooting (1).stl
58.0 x 185.0 x 50.0
