malakmarwan/Space-Garden/Mechanical/bearing 17 mm cuscinetto flangiato piatto.STEP

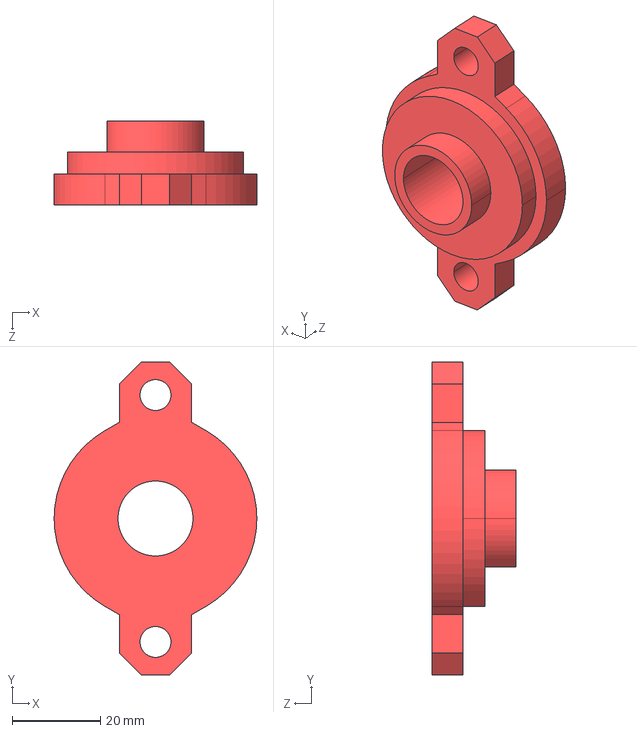
[picture p66: CAD file, 2026-06-09]
Mechanical/bearing 17 mm cuscinetto flangiato piatto.STEP
46.0 x 71.0 x 19.0 mm
