malakmarwan/Space-Garden/Mechanical/LCD DISPLAY MODEL.STEP

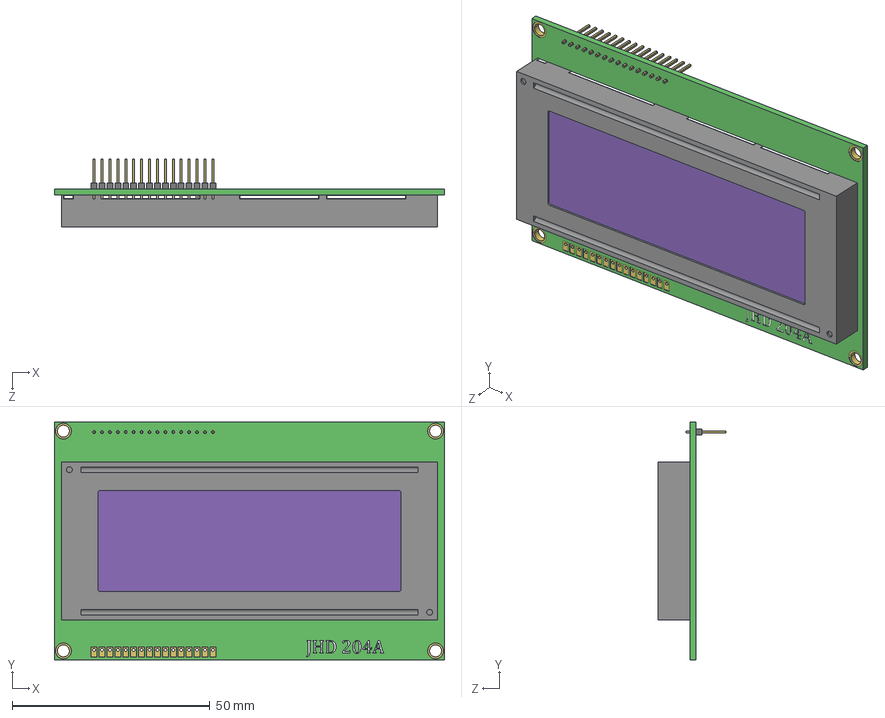
[picture p67: CAD file, 2026-06-09]
Mechanical/LCD DISPLAY MODEL.STEP
98.5 x 60.0 x 17.1 mm
