malakmarwan/Space-Garden/Mechanical/cover el shooting 3.1aiso.stl

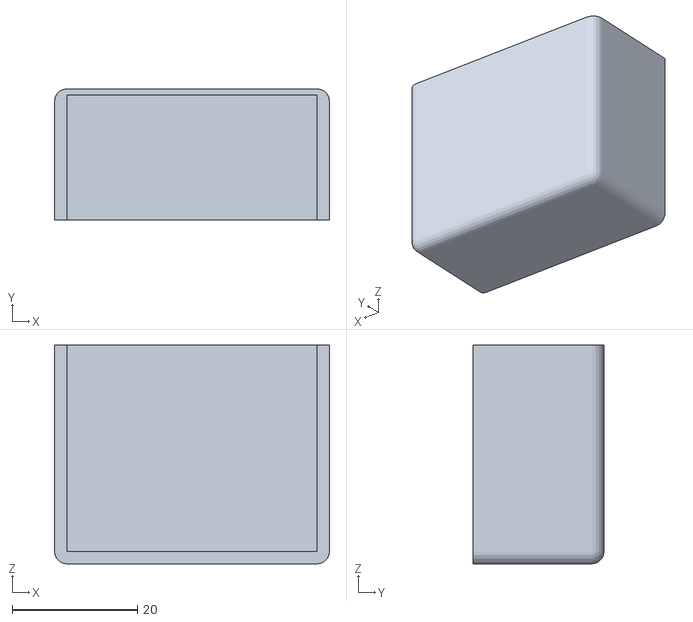
[picture p68: CAD file, 2026-06-09]
Mechanical/cover el shooting 3.1aiso.stl
44.0 x 21.0 x 35.0
