malakmarwan/Space-Garden/Mechanical/4x3_Keypad.stp

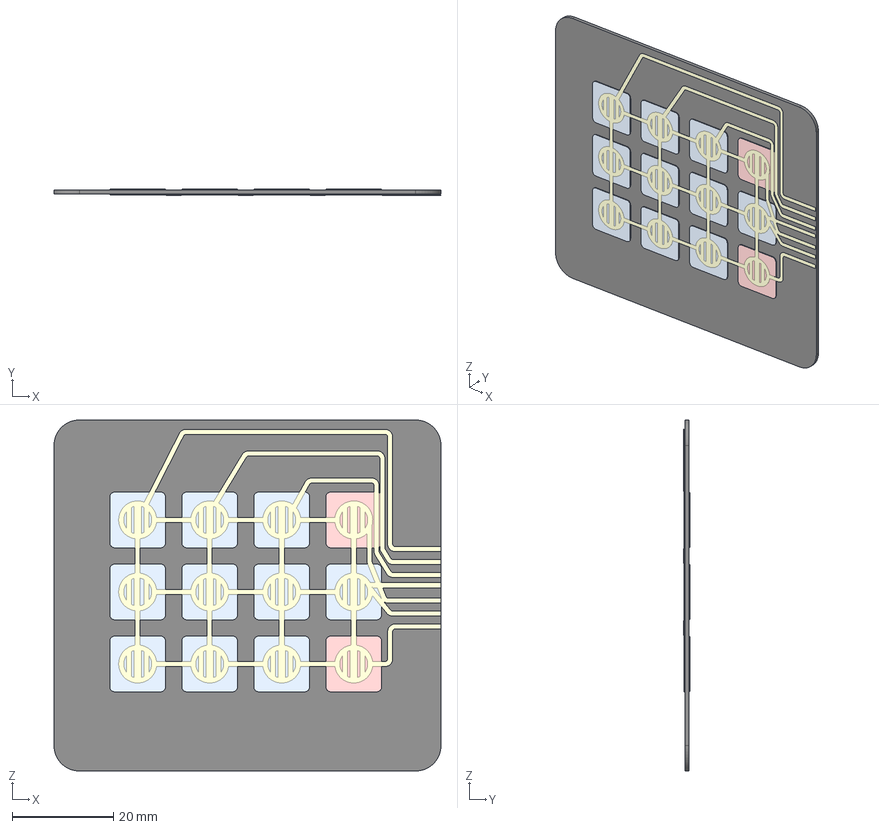
[picture p69: CAD file, 2026-06-09]
Mechanical/4x3_Keypad.stp
76.3 x 1.22 x 69.2 mm
