malakmarwan/Space-Garden/(list of files, cad)

Other CAD files:
Mechanical/Assembly4 sorting.iam
Mechanical/Base.ipt
Mechanical/Clamp.ipt
Mechanical/Part1 box.ipt
Mechanical/Part2 box.ipt
Mechanical/Part3 box..ipt
Mechanical/Part4 box.ipt
Mechanical/Q side 1.ipt
Mechanical/Q side 2.ipt
Mechanical/Q side 3.ipt
Mechanical/Q top 2.ipt
Mechanical/Q top1 new.ipt
Mechanical/afterr.ipt
Mechanical/base prt 1 N.ipt
Mechanical/base prt 2 N.ipt
Mechanical/box cover.ipt
Mechanical/box.ipt
Mechanical/catapult assembly new arm.iam
Mechanical/color.ipt
Mechanical/cover shooting 222.ipt
Mechanical/lifting mechanism.ipt
Mechanical/track box.ipt
