malakmarwan/Space-Garden/Electrical/integrated wiring diagram.png

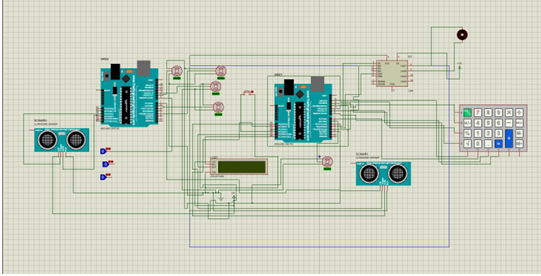
Electrical/integrated wiring diagram.png
