malakmarwan/Space-Garden/Electrical/lifting mechanism wiring diagram.png

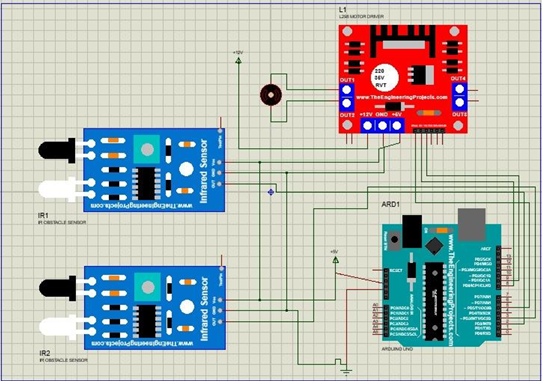
Electrical/lifting mechanism wiring diagram.png
