malakmarwan/Space-Garden/Electrical/PCB printed.png

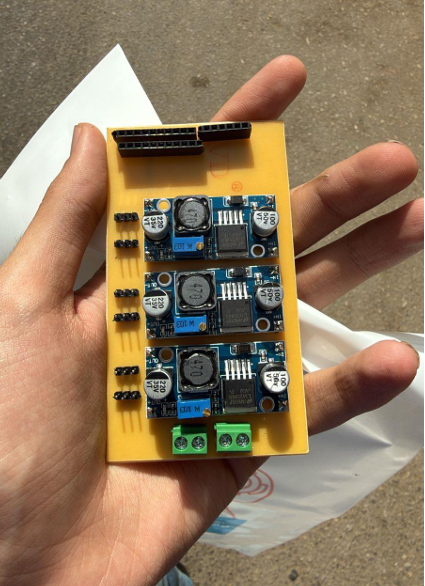
Electrical/PCB printed.png
