malakmarwan/Space-Garden/Electrical/shooting mechanism wiring diagram.png

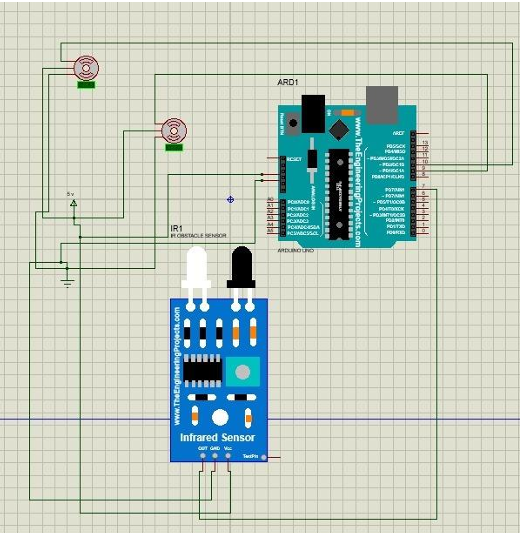
Electrical/shooting mechanism wiring diagram.png
