malakmarwan/Space-Garden/(commit log)

2026-06-09 Create cad files.txt
2026-06-11 Create Code on Arduino 1
2026-06-11 Create Code on Arduino 2
